EtienneESP32/fil-pilote-8-zones-eedomus/docs/11_Etat-KiCad.md

# État du projet KiCad natif

**Statut (2026-11-07, révisé) :** schéma électriquement complet et vérifié ERC ; implantation PCB placée et vérifiée DRC (hors routage). Ce projet KiCad devient la référence pour la topologie électrique — il intègre toutes les clôtures du 2026-11-06 (GPIO corrigés, étage tampon transistor, 4,7 kΩ + fusibles secteur, HLK-5M05, MOC3063M) que la copie EasyEDA R1 (`FilPilote_8Zones_DIN_R1_2026-11-06`, voir [08_Revue-schema-source](08_Revue-schema-source.md)) ne contient pas encore.

**Correction importante (2026-11-07) :** l'empreinte du connecteur de la carte Waveshare, livrée dans une première version de ce document, était un connecteur générique 1 rangée / 19 broches — sans rapport avec le vrai connecteur de la carte, repérée par l'utilisateur. Voir « Correction du connecteur Waveshare » ci-dessous pour le détail et les conséquences (deux affectations GPIO supplémentaires corrigées).

## Emplacement

- `hardware/kicad/FilPilote_8Zones.kicad_pro` — projet
- `hardware/kicad/FilPilote_8Zones.kicad_sch` — schéma (généré, voir `tools/generate_schematic.ps1`)
- `hardware/kicad/FilPilote_8Zones.kicad_pcb` — PCB (généré, voir `tools/generate_pcb.ps1`)
- `hardware/kicad/*.erc.json`, `*.drc.json` — rapports de vérification bruts
- `hardware/kicad/FilPilote_8Zones_render.png` — rendu visuel du placement

## Méthode

Le schéma et le PCB sont produits par deux scripts PowerShell (`tools/generate_schematic.ps1`, `tools/generate_pcb.ps1`) qui écrivent directement les fichiers texte `.kicad_sch`/`.kicad_pcb` au format KiCad 10, plutôt que d'utiliser l'éditeur graphique (non disponible dans cet environnement). Les symboles et empreintes sont des définitions minimales propres au projet (bibliothèque `FP`, non enregistrée dans une table de bibliothèque — d'où les avertissements bénins « bibliothèque FP introuvable » dans les rapports, sans impact électrique), à l'exception du connecteur Waveshare dont la géométrie a été vérifiée contre le vrai composant (voir ci-dessous). Chaque script a été validé empiriquement avec `kicad-cli` (erreurs de format corrigées par itération : inversion d'axe Y des broches de symbole, pas de grille, calcul d'offset, opérateur PowerShell qui répétait un tableau au lieu de multiplier une valeur).

**Piège `kicad-cli` trouvé (2026-11-07), à connaître avant toute régénération :** `kicad-cli pcb drc` et `kicad-cli pcb export svg` utilisent correctement les classes de net personnalisées (`Logique`/`Secteur`) pour le calcul demandé, **mais réécrivent ensuite `FilPilote_8Zones.kicad_pro` sur disque en supprimant ces classes** (seule la classe `Default` subsiste, `netclass_patterns` revient à `[]`) — un comportement de synchronisation de projet non documenté, pas une erreur de ce projet. Le résultat du DRC lancé À CE MOMENT-LÀ reste correct, mais le fichier projet est corrompu juste après et le resterait pour tout DRC ultérieur si on ne le restaure pas. **Toujours vérifier après toute commande `kicad-cli` touchant ce projet** (`git status` sur `FilPilote_8Zones.kicad_pro`, ou `grep -c Secteur` dessus) et restaurer (`git checkout -- hardware/kicad/FilPilote_8Zones.kicad_pro`) avant de committer. Pour un export SVG ou autre besoin ponctuel, préférer travailler sur une copie du projet dans un répertoire temporaire plutôt que sur les fichiers réels.

## Correction du connecteur Waveshare (2026-11-07)

**Ce qui était faux :** le connecteur `JWS` modélisait une rangée unique de 19 broches arbitraires, sans rapport avec la géométrie réelle de la carte Waveshare ESP32-S3-ETH.

**Vérification faite :** le pinout physique réel a été récupéré ([espboards.dev](https://www.espboards.dev/esp32/waveshare-esp32-s3-eth/), recoupé avec le wiki fabricant). La carte fait 72,8 × 21 mm et porte un **en-tête 40 broches compatible Raspberry Pi Pico** : 2 rangées de 20 broches, pas 2,54 mm, rangées espacées de 17,78 mm. Le connecteur `FP:CONN40_PICO` a été refait à l'identique de cette géométrie (vérifié par inspection directe des coordonnées de pastilles générées : deux colonnes à 10,00 mm et 27,78 mm d'écart exact).

**Deux erreurs d'affectation GPIO découvertes en croisant le pinout physique réel** (en plus de la correction GPIO33/34 déjà actée le 2026-11-06) :

| Zone/voie | GPIO précédent | Problème | GPIO corrigé |
|---|---:|---|---:|
| Zone 4, voie B | GPIO4 | Ne sort que sur le connecteur carte TF, absent de l'en-tête principal câblable | **GPIO45** |
| Zone 5, voie A | GPIO5 | Idem (carte TF uniquement) | **GPIO3** (broche de strapping JTAG ESP32-S3 ; risque limité à la sélection de source JTAG au démarrage, pas un risque de boot ; accepté faute d'alternative libre) |
| Zone 4, voie A | GPIO21 | Partagé avec la LED WS2812 embarquée de la carte | **Conservé** ; effet cosmétique accepté (la LED de statut suivra l'état de la zone 4 POS) |
| — | — | GPIO46 présent sur l'en-tête mais **entrée seule** sur ESP32-S3 | Exclu des candidats |

Table complète et à jour dans [02_Architecture-et-interfaces §2](02_Architecture-et-interfaces.md).

**Point fermé (2026-11-07), schéma fabricant réel consulté :** le schéma officiel ([ESP32-S3-ETH-Schematic.pdf](https://files.waveshare.com/wiki/ESP32-S3-ETH/ESP32-S3-ETH-Schematic.pdf)) montre que `POE_5V` est le même net que `VBUS` (USB-C) côté Waveshare — le module PoE s'enfiche sur un connecteur interne dédié, pas sur l'en-tête 40 broches. `VSYS` (broche 2) est la seule entrée externe accessible, déjà commutée en interne entre `VBUS`/PoE par un MOSFET (Q3, APM2307). Le sélecteur manuel `SW1` prévu initialement est donc **retiré** : il n'y a rien à sélectionner entre deux broches externes. Remplacé par une simple **diode série** (`DPWR`, 1N4007, anode HLK-5M05 / cathode `VSYS`) qui protège le HLK-5M05 d'un retour si le module PoE est malgré tout installé en parallèle. L'exclusion mutuelle PoE/local devient un choix d'assemblage à documenter dans la notice, pas un circuit électronique.

## Résultats de vérification (après correction)

- **ERC (schéma) :** 0 erreur, 0 avertissement résiduel hors bibliothèque. 248 avertissements bénins « bibliothèque FP introuvable », sans incidence électrique.
- **DRC (PCB) :** 0 erreur réelle. 138 avertissements bénins (même cause bibliothèque), **0 avertissement cosmétique résiduel** (les 6 chevauchements de repère silkscreen ont disparu après le recentrage des repères dans l'empreinte, voir plus bas — 2026-11-08). **144 des 188 connexions routées automatiquement par un autorouteur A* bicouche avec lissage de trajet** (F.Cu/B.Cu avec vias, 2 passes, conscient des classes de net Secteur/Logique, pistes lissées en ligne directe/diagonale quand c'est sûr plutôt qu'en escalier — script, voir [12_Guide-de-routage §0](12_Guide-de-routage.md)). Les 44 restantes ne sont pas simplement « non connectées » : elles sont matérialisées en **straps** directement dans le fichier `.kicad_pcb` (ligne de repère + étiquette sur la couche `Dwgs.User`, générées automatiquement, visibles à l'ouverture du PCB), avec une vérification réelle — pas une supposition — de la nécessité d'un fil isolé selon la proximité calculée avec l'autre classe de net (voir [12_Guide-de-routage §2](12_Guide-de-routage.md)).
- **Carte resserrée, 192 → 176 → 167 mm (2026-11-08) :** demande directe de l'utilisateur, en 2 temps. D'abord un pas variable (7 mm entre composants fins, 8 mm de part et d'autre de l'optotriac, remplaçant le pas uniforme de 9 mm — les composants 2 broches tournés à 90° n'ont quasiment aucun encombrement horizontal au-delà du rayon de leur pastille) + colonne connectique secteur/FP rapprochée (192→176 mm). Puis, l'utilisateur ayant repéré un **2e vide inutilisé au centre de la carte** (entre la colonne gauche de canaux et la colonne droite, ~21 mm de cuivre inutilisé) : colonnes rapprochées d'autant (176→167 mm), sans toucher au pas interne des canaux cette fois (donc sans nouveau risque sur le routage, confirmé : 144/188 inchangé). Un resserrement plus agressif du PAS interne (155 mm au lieu de 176 mm) a aussi été testé puis rejeté par l'utilisateur : 0 erreur DRC, mais 67 straps à souder au lieu de 34 (quasiment le double) — compromis jugé trop coûteux, non retenu. Conséquence attendue et acceptée du pas 7/8 mm retenu (176→167 mm) : 154 → 144 connexions auto-routées (34 → 44 straps), un vrai compromis taille/travail d'assemblage manuel, pas une régression.
- **Repères de valeur (ex. « 1N4007 », « 10k ») alignés sur le repère de référence (2026-11-08) :** signalé par l'utilisateur — seul le repère de référence (ex. « DZ1N ») avait été mis à la verticale/collé au composant ; la valeur restait horizontale et à son décalage par défaut. Corrigé en appliquant la même logique (même rotation, même côté, un peu plus loin pour ne pas chevaucher le repère de référence) à la propriété Value de tous les composants de canal, et à l'intérieur du boîtier de l'optotriac (empilée sous le repère de référence, toujours dans l'espace vide entre les 2 rangées de broches).
- **Pastilles d'ancrage de strap réactivées, numérotées par paire (2026-11-08) :** après un premier abandon le même jour (voir [12_Guide-de-routage §0](12_Guide-de-routage.md)), l'utilisateur a demandé de retenter l'idée avec un numérotage pairable — chaque strap a ses 2 extrémités numérotées pareil, suffixées A/B (ex. `S5A`/`S5B`), au lieu de 2 numéros globaux sans rapport visible entre eux. En la retentant (la dernière correction, jamais vérifiée avant l'abandon par manque de temps, s'est avérée fonctionner), résultat : **0 erreur DRC réelle**, 13 paires de pastilles d'ancrage posées avec succès sur 44 straps (les autres retombent proprement sur la connexion directe pastille-à-pastille, toujours sûre — pas une anomalie). 6 avertissements cosmétiques résiduels (chevauchement mineur de repère), laissés pour la finition silkscreen.
- **Repères silkscreen corrigés à la racine (2026-11-08) :** signalé par l'utilisateur en regardant le board. Vérifié par export SVG (pas supposé) que l'angle du texte n'hérite pas de la rotation du composant parent — le texte restait donc horizontal, mais décalé de 4 mm *vers un voisin*, ce qui causait 16 vrais chevauchements DRC (`silk_over_copper`), systématiquement le même (le repère `RS` pointant droit vers l'optotriac, large de 9,62 mm). Corrigé par deux changements demandés par l'utilisateur : le texte est maintenant tourné à 90° (se lit le long de l'axe du composant, comme ses broches empilées) et collé à seulement 1,8 mm au lieu de 4 mm ; et le repère de l'optotriac est placé **à l'intérieur même de son boîtier**, dans l'espace vide entre ses 2 rangées de broches (DIP-6 non tourné). Résultat : 0 avertissement silkscreen résiduel.
- **Correction d'implantation E/S RJ45 vs J1-J5, carte resserrée 167→154 mm (2026-11-08) :** l'utilisateur a demandé la vérification, sur le datasheet réel du coffret, que le RJ45 et les borniers J1-J5 sortent bien par des côtés compatibles avec les découpes du boîtier CNMB (deux extrémités opposées de l'axe qui scale avec le nombre de modules, jamais les deux grands côtés fixes à 86,5 mm). Vérification faite : J1-J5 sortent correctement vers le bord droit (une extrémité valide), mais le module Waveshare (`JWS`), monté à la verticale pour rester compact, a son RJ45 regroupé avec l'USB-C à une extrémité du module de 72,8 mm qui, dans cette orientation, sort vers le bord **haut** de la carte — un grand côté fixe, sans découpe standard (confirmé par le schéma de cotes officiel Waveshare, pas une supposition). Tourner le module de 90° pour aligner le RJ45 sur un bord valide coûterait directement 72,8 mm de largeur de carte, incompatible avec tout objectif de compaction. **Solution retenue avec l'utilisateur :** le module reste monté tel quel ; son RJ45 est relié par un court cordon interne à une prise RJ45 secondaire fixée au bord gauche (opposé à J1-J5) — liaison par câble, aucune piste PCB supplémentaire (détail mécanique dans [04_Implantation-PCB §1 et §6](04_Implantation-PCB.md)). À cette occasion, les 3 vides inter-colonnes (en-tête Waveshare↔zone gauche, zone gauche↔zone droite, zone droite↔connectique secteur) ont été resserrés sans toucher au pas interne des canaux (`$gapThin`/`$gapOC` inchangés, donc pas de risque supplémentaire sur le nombre de straps — confirmé : toujours 144/188 routées, 44 straps, inchangé) : carte 167→**154 mm**, sous la limite réelle CNMB/9 (156 mm utiles) avec 2 mm de marge. Les repères (`Reference`) et valeurs des composants axiaux 2 broches du canal (RB, RL, RS, F, D) ont en même temps été recentrés **dans** l'empreinte (même principe que l'optotriac, pas de pastille au centre local d'un axial 2 broches) au lieu de déborder de 1,8-2,8 mm vers un voisin — suggestion de l'utilisateur, qui a aussi fait disparaître les 6 avertissements cosmétiques de chevauchement silkscreen (voir ci-dessus). `Q` (TO92_3, 3 broches dont une au centre) garde son décalage latéral, le centre étant occupé par une pastille.
- **Correction de sécurité (2026-11-07) :** une vraie règle DRC d'isolement secteur/logique (6 mm, classes de net + fichier `.kicad_dru`) a été ajoutée — elle n'existait nulle part avant, voir [04_Implantation-PCB §3](04_Implantation-PCB.md). Son activation a révélé 234 violations réelles de placement (52 sous le minimum réglementaire IEC 60664-1), corrigées à la racine en changeant l'orientation d'un seul composant (l'optotriac, qui ne doit pas être tourné à 90° comme les autres). Le nombre de connexions auto-routées a baissé (172 → 153, puis remonté à 154 avec le lissage de trajet ajouté ensuite) non pas par régression, mais parce que le DRC vérifie désormais une contrainte réelle qu'il ignorait avant — la version précédente à 172 routées était **plus routée mais électriquement non sûre**.

## Ce que ça couvre

- Les 8 zones × 2 voies (POS/NEG), chacune : résistance de base → transistor tampon → résistance LED → MOC3063M → résistance secteur 4,7 kΩ → fusible/PTC → diode → sortie FPx, conforme aux décisions fermées du 2026-11-06.
- Section alimentation : diode anti-retour PoE/local (`DPWR`), HLK-5M05, AMS1117 dédié aux LED d'opto, découplage.
- Connectique : J1 (secteur), J2-J5 (FP1-FP8), en-tête Waveshare 40 broches réel (GND, VSYS, 16×GPIO câblés sur leurs broches physiques réelles ; les 21 autres broches — VBUS/3V3/3V3_EN/RUN/GPIO non retenus/réservés — sont non connectées).
- Implantation : colonne gauche (en-tête Waveshare + alimentation), 8 zones au centre en 4 bandes horizontales de 2 zones chacune, connectique secteur/FP en bord de carte droit.

## Révision du gabarit de carte et boîtier candidat

Le placement réel des 16 voies THT a montré que 105 × 85 mm (gabarit indicatif de la source) ne suffit pas. Une première extension à 105 × 180 mm a été reconsidérée : la hauteur d'un boîtier rail DIN modulaire est fixée par la gamme du fabricant, pas une dimension libre — seule la largeur varie avec le nombre de modules (1 module = 17,5 mm). La carte a d'abord été réorientée en 192 × 108 mm (~11 modules de large).

**Référence étudiée (2026-11-07) :** la gamme **CamdenBoss CNMB** (norme DIN 43880, quasi tous fabricants, disponible chez RS Components), datasheet officiel consulté. Section fixe **90 mm externe / 86,5 mm de PCB utilisable**, longueur qui scale avec le nombre de modules (`CNMB/12` = 212,1 mm, convient à notre longueur de 192 mm avec marge). Avantages concrets pour ce projet : **découpe RJ45 pré-percée disponible en pièce standard** (`CNMB/3/TGRJ45`, compatible tailles 3/6/9/12 — répond au point ouvert d'accès RJ45) et guide-fils/protège-bornes au pas **5,08 mm** (`CNMB/x/TG508`), qui correspond exactement au pas des borniers FP retenus dans la nomenclature.

**Carte recompactée en conséquence :** la carte 192×108 mm dépassait les 86,5 mm utilisables dans le sens de la section. Recompactée à **192 × 86 mm** (pas des bandes de zones resserré, dégagement de bord recalculé en tenant compte du rayon réel des pastilles) pour tenir en carte unique sous ce seuil, plutôt qu'un empilement de 2 PCB (également supporté par ce boîtier : « carries up to 3 PCBs horizontally »). DRC revalidé à 0 erreur réelle après compaction.

**Boîtier retenu, mis à jour (2026-11-08) :** base **CNMB/9/2** (156 mm de PCB utilisable, accès bornier aux deux extrémités opposées), couvercle **CNMB/9/PC** (transparent, choisi par l'utilisateur) — remplace le `CNMB/12` retenu le 2026-11-07, devenu surdimensionné une fois la carte resserrée à 154 mm. Accessoires : `CNMB/3/TGRJ45` × 3 au bord gauche (prise RJ45 secondaire + cordon interne depuis le module Waveshare, voir correction d'implantation E/S ci-dessus), `CNMB/3/TG508` × 3 côté J1-J5 (guide-fils 5,08 mm) — un CNMB/9 nécessite 3 segments modulaires de 52,8 mm par extrémité pour couvrir la largeur du boîtier. L'entrée secteur J1 est câblée en fixe par presse-étoupe plutôt qu'en bornier débrochable (évite un débranchement accidentel d'un conducteur 230 V) — voir [03_Nomenclature](03_Nomenclature.md).

**Confirmation CNMB/9 (2026-11-08) :** datasheet officiel CamdenBoss consulté directement (pas une extrapolation) — la gamme ne compte que les tailles /6, /9, /12 (pas de /8/10/11), avec une longueur de PCB utilisable réelle de 156 mm pour le /9. La carte à 154 mm y tient avec 2 mm de marge. Référence toujours à reconfirmer auprès du fabricant avant commande, même démarche que pour le `CNMB/12` initial.

**Profondeur interne vérifiée (2026-11-07) :** empilement réel depuis le PCB porteur jusqu'au point le plus haut = support femelle 2,54 mm (8,5 mm, hauteur standard du commerce) + épaisseur PCB Waveshare (1,6 mm) + composant le plus haut de la carte Waveshare, la prise RJ45 à magnétiques intégrées référencée `HC-RJ45` sur le schéma réel (≈13,4 mm, valeur typique pour ce type de connecteur) ≈ **23,5 mm au total**. Côté boîtier, 58 mm de profondeur externe moins parois et plots de fixation (≈5 mm) laisse ≈49 mm de dégagement utile. **Marge ≈2× le besoin** : la profondeur n'est pas un facteur limitant, même avec des hauteurs de composants estimées prudemment (pas mesurées sur pièce réelle).

## Orientation des borniers de câblage externe (2026-11-07)

**Ce qui était faux :** `J1` (secteur) et `J2`-`J5` (sorties FP) étaient posés à plat (rotation 0°), axe des 2 broches parallèle au bord de carte — sans rapport avec le sens de sortie réel d'un câble externe, signalé par l'utilisateur.

**Correction :** rotation à 90°, axe des 2 broches perpendiculaire au bord droit de la carte (sortie fil vers l'extérieur, X croissant). Vérifié par inspection directe des coordonnées de pastilles générées (ex. `J1` : les deux broches partagent `x=187.0`, espacées en `y` de ±2,54 mm autour du centre — confirmant l'axe perpendiculaire au bord). `F0` (fusible) et `PS1` (module HLK-5M05) n'ont pas de câblage externe direct (traces PCB uniquement) : orientation inchangée. DRC revalidé à 0 erreur réelle.

**Reste non traité :** le sens exact (quelle broche est « plus proche »/« plus loin » du bord) dépend de la référence réelle du bornier, pas encore choisie ; la position le long du bord (regroupement actuel près du coin) reste à confronter aux presse-étoupes/découpes réelles du boîtier une fois celui-ci commandé.

**Cohérence avec les 2 extrémités valides du boîtier, vérifiée (2026-11-08) :** J1-J5 sortent vers le bord droit, l'une des deux seules extrémités du CNMB où une découpe de câblage existe réellement (voir correction d'implantation E/S ci-dessus pour le cas du RJ45, qui lui ne sortait PAS d'un bord valide avant correction).

## Ce qui n'est pas fait

- **Routage des pistes** : un autorouteur A* bicouche (F.Cu/B.Cu, vias autorisés, 2 passes, conscient des classes Secteur/Logique, trajets lissés pour éviter les escaliers inutiles) par script a tracé 144 des 188 connexions (voir [12_Guide-de-routage §0](12_Guide-de-routage.md)). Les 44 restantes (surtout `MT1D_*` et `GPIO*` longue distance) sont bloquées localement par la saturation des 2 couches dans leur zone — plus nombreuses qu'avant le resserrement de la carte (192→167mm), compromis accepté — elles sont matérialisées en straps (guide + étiquette sur `Dwgs.User`, voir [12_Guide-de-routage §2](12_Guide-de-routage.md)) à souder à l'assemblage, pas à router en cuivre ; 13 d'entre elles ont en plus une paire de pastilles d'ancrage numérotées (`SxA`/`SxB`) pour faciliter le soudage.
- **Empreintes définitives des autres composants** : les empreintes hors connecteur Waveshare restent des gabarits génériques auto-cohérents (ex. `FP:DIP6`, `FP:TO92_3`), pas les empreintes réelles des références fabricant choisies. Elles sont correctes électriquement (mêmes numéros de broches que le schéma) mais leurs dimensions/pas exacts restent à confronter aux datasheets avant fabrication.
- **Plans de masse** : non définis (les classes de nets et largeurs de piste secteur/logique, elles, le sont désormais — voir [04_Implantation-PCB §3](04_Implantation-PCB.md)).
- **Table de bibliothèque locale** (`sym-lib-table`/`fp-lib-table`) : non créée ; à faire pour que KiCad propose nativement les symboles/empreintes en édition graphique (actuellement seulement en cache dans les fichiers, fonctionnel mais pas éditable comme bibliothèque séparée).
