EtienneESP32/fil-pilote-8-zones-eedomus/contour du projet.docx

Voici une synthèse technique complète, claire et sans ambiguïté à copier-coller directement pour soumettre votre projet à Claude :

# Synthèse Projet : Carte Contrôleur Fil Pilote 8 Zones (Rail DIN / ESP32 Ethernet)

## 1. Objectif du projet

Concevoir sous **EasyEDA Standard** le schéma et le circuit imprimé (PCB) d'une carte de pilotage pour **8 zones de chauffage par Fil Pilote**, intégrable dans un boîtier rail DIN (6 modules / 105 mm).

* **Contrainte d'assemblage :** Composants **100 % traversants (THT)** uniquement. Zéro CMS/SMD. Tout doit être soudable à la main sur pastilles perçées ou monté sur supports (DIP, barrettes femelles 2,54 mm).

* **Intégration domotique :** Firmware ESPHome / Home Assistant avec raccordement réseau filaire local (RJ45).

## 2. Architecture matérielle

### A. Contrôle & Connectivité

* **Microcontrôleur principal :** Platine **WT32-ETH01** (ESP32 avec port RJ45 femelle, PHY Ethernet LAN8720A, régulateur 3.3V intégré).

* Montée sur barrettes femelles THT au pas de 2,54 mm.

* Alimentation de la platine : sur sa broche `5V` (alimentée par le 5V du Hi-Link) et `GND`.

* Bus I2C pour communiquer avec l'expandeur : `IO33` (SDA) et `IO32` (SCL) (les broches standard 21/22 étant mobilisées en interne par l'Ethernet sur cette platine).

* **Expandeur d'E/S (I/O Expander) :** **MCP23017-E/SP** (boîtier DIP-28 THT).

* Alimentation : `VDD` sur `+3V3` (fourni par la broche 3V3 de la platine WT32-ETH01 ou rail 3.3V), `VSS` sur `GND`.

* Adresse I2C : broches 15, 16, 17 (`A0`, `A1`, `A2`) reliées à `GND` $\to$ adresse `0x20`.

* Broche 18 (`~RESET`) : portée au `+3V3`.

* Bus I2C : broche 12 (`SCL`) et broche 13 (`SDA`), avec résistances de tirage (*pull-up*) de 4,7 kΩ vers le `+3V3`.

* Sorties logiques : 16 E/S réparties pour piloter les 8 zones (2 sorties logiques par zone).

### B. Alimentation

* **Source primaire :** Module convertisseur AC/DC **HLK-PM01** (230V AC $\to$ 5V DC 600mA, boîtier fermé THT).

* Entrée 230V : reliée au bornier 2 pôles secteur `J1` (`N` et `L`).

* **Ligne Phase de commande (`PHASE_PROT`) :**

* La Phase 230V du bornier `J1` est distribuée vers l'étage de découpage des optotriacs sous le label `PHASE_PROT` (avec fusible 250V THT préconisé).

### C. Étage de puissance Fil Pilote (Répété à l'identique pour 8 zones)

Chaque zone est pilotée par 2 sorties logiques du MCP23017 :

1. **Alternance positive (Ordre Arrêt) :** active l'opto `POS`

2. **Alternance négative (Ordre Hors-Gel) :** active l'opto `NEG`

3. **Plein 230V sinusoïdal (Ordre Éco) :** active les deux optos simultanément

4. **Zéro signal (Ordre Confort) :** deux optos éteints

**Nomenclature par Zone :**

* 2 × Optotriacs : **MOC3041M** (DIP-6 THT) avec détection de passage par zéro (Zero-Crossing).

* 2 × Diodes : **1N4007** (boîtier DO-41 THT, 1000V 1A).

* 2 × Résistances côté commande basse tension : **330 Ω** 1/4W (axiale THT `AXIAL-0.3`).

* 2 × Résistances côté 230V secteur : **360 Ω** 1/2W ou 1/4W (axiale THT `AXIAL-0.3` ou `AXIAL-0.4`).

**Câblage type de la Zone X :**

* `Zx_POS` $\to$ Résistance 330 Ω $\to$ Broche 1 de l'opto 1 ; Broche 2 de l'opto 1 $\to$ `GND`.

* `Zx_NEG` $\to$ Résistance 330 Ω $\to$ Broche 1 de l'opto 2 ; Broche 2 de l'opto 2 $\to$ `GND`.

* `PHASE_PROT` $\to$ Résistance 360 Ω $\to$ Broche 6 de l'opto 1.

* `PHASE_PROT` $\to$ Résistance 360 Ω $\to$ Broche 6 de l'opto 2.

* Broche 4 de l'opto 1 $\to$ Anode de Diode 1 ; Cathode de Diode 1 $\to$ Nœud de sortie `FPx`.

* Broche 4 de l'opto 2 $\to$ Cathode de Diode 2 ; Anode de Diode 2 $\to$ Nœud de sortie `FPx`.

### D. Connectique externe (Borniers THT au pas de 5,0 mm / 5,08 mm)

* 1 × Bornier 2 pôles (**`J1`**) : Entrée 230V Secteur (Phase `L`, Neutre `N`).

* 4 × Borniers 2 pôles débrochables ou à vis (**`J2`, `J3`, `J4`, `J5**`) pour les 8 sorties Fil Pilote :

* Bornier 1 : `FP1`, `FP2`

* Bornier 2 : `FP3`, `FP4`

* Bornier 3 : `FP5`, `FP6`

* Bornier 4 : `FP7`, `FP8`

*(Note : les radiateurs ont leur neutre directement relié au tableau électrique).*

## 3. Cartographie d'adressage MCP23017 $\leftrightarrow$ Zones

| Sortie MCP23017 | Broche DIP-28 | Net Label | Zone associée |

| **GPA0** | Broche 21 | `Z1_POS` | Zone 1 (Arrêt) |

| **GPA1** | Broche 22 | `Z1_NEG` | Zone 1 (Hors-Gel) |

| **GPA2** | Broche 23 | `Z2_POS` | Zone 2 (Arrêt) |

| **GPA3** | Broche 24 | `Z2_NEG` | Zone 2 (Hors-Gel) |

| **GPA4** | Broche 25 | `Z3_POS` | Zone 3 (Arrêt) |

| **GPA5** | Broche 26 | `Z3_NEG` | Zone 3 (Hors-Gel) |

| **GPA6** | Broche 27 | `Z4_POS` | Zone 4 (Arrêt) |

| **GPA7** | Broche 28 | `Z4_NEG` | Zone 4 (Hors-Gel) |

| **GPB0** | Broche 1 | `Z5_POS` | Zone 5 (Arrêt) |

| **GPB1** | Broche 2 | `Z5_NEG` | Zone 5 (Hors-Gel) |

| **GPB2** | Broche 3 | `Z6_POS` | Zone 6 (Arrêt) |

| **GPB3** | Broche 4 | `Z6_NEG` | Zone 6 (Hors-Gel) |

| **GPB4** | Broche 5 | `Z7_POS` | Zone 7 (Arrêt) |

| **GPB5** | Broche 6 | `Z7_NEG` | Zone 6 (Hors-Gel) |

| **GPB6** | Broche 7 | `Z8_POS` | Zone 8 (Arrêt) |

| **GPB7** | Broche 8 | `Z8_NEG` | Zone 8 (Hors-Gel) |

## 4. État d'avancement actuel & Problématique restante

1. **Schéma :** Le bloc unitaire Zone 1 est validé électriquement. La duplication logique via Net Labels est arrêtée.

2. **Point à finaliser immédiatement :**

* Remplacement de l'ancien symbole CMS `WT32-S1` par la véritable empreinte THT de la platine **`WT32-ETH01`** dans EasyEDA.

* Vérification des broches I2C libres (`IO33` / `IO32` vs `IO4` / `IO14`) sur cette platine spécifique.

* Passage sous l'éditeur de PCB : dimensionnement du contour pour boîtier DIN (ex: 105 × 85 mm), placement physique garantissant la **barrière d'isolation galvanique de sécurité (crepage/clearance $\ge 6$ mm)** entre le plan secteur 230V et la logique basse tension, puis stratégie de routage des pistes 230V et du bus logique.
