EtienneESP32/fil-pilote-8-zones-eedomus/docs/05_Firmware-et-exploitation.md

# Firmware et exploitation

**Statut :** exigences fonctionnelles proposées; aucun firmware n'est présent dans le dossier. L'intégration visée est eedomus, sans Home Assistant.

## 1. Plateforme et intégration

- Contrôleur candidat : Waveshare ESP32-S3 ETH avec Ethernet/RJ45 et PoE proposé, Wi-Fi et Bluetooth.
- Protocole d'intégration eedomus à définir; proposition initiale : API HTTP locale appelée par eedomus, avec commandes de mode et lecture de statut.
- Home Assistant n'est pas requis.
- MCP23017/I2C retiré de l'architecture (2026-11-06) : 16 GPIO directs confirmés, chacun pilotant un transistor tampon (voir [02_Architecture](02_Architecture-et-interfaces.md)).

Le pinout et le mécanisme réseau de la carte Waveshare devront être vérifiés avant le firmware. L'API eedomus devra préciser l'authentification locale, le format des commandes, l'accusé de réception et la lecture d'état.

## 2. Convention de commande par zone

| Ordre | Codage matériel/temps | Statut |
|---|---|---|
| Confort | À spécifier selon GIFAM | Ouvert |
| Éco | À spécifier selon GIFAM | Ouvert |
| Hors-gel | À spécifier selon GIFAM | Ouvert |
| Arrêt | À spécifier selon GIFAM | Ouvert |
| Confort -1 °C | À spécifier selon GIFAM | Ouvert |
| Confort -2 °C | À spécifier selon GIFAM | Ouvert |

La paire de sorties de la conception initiale fournit quatre combinaisons statiques seulement. Les six ordres exigent une table de génération comprenant les éventuelles séquences temporelles; ne pas coder les modes avant validation de cette table et du circuit de puissance.

Référence de travail à examiner : [`epsilonrt/gifam-chip`](https://github.com/epsilonrt/gifam-chip) décrit Confort -1 °C comme signal complet 3 s / silence 4 min 57 s, et Confort -2 °C comme signal complet 7 s / silence 4 min 53 s. Ces temporisations sont une implémentation communautaire à confirmer avant intégration finale.

## 3. Séquence de démarrage attendue

À spécifier et tester :

1. Maintenir les sorties dans l'état matériel sûr pendant l'alimentation et le reset.
2. Initialiser les GPIO et les drivers à un état connu avant d'accepter des commandes réseau.
3. Charger la dernière consigne persistée, appliquer le mode seulement après initialisation complète et signaler tout échec.
4. Signaler l'état réseau séparément de l'état réel ou présumé des sorties.

L'état sûr exact et la politique de reprise restent à décider avec le comportement des appareils de chauffage. Ne pas supposer que « toutes les sorties à zéro » est le choix sûr sans valider le système complet.

## 4. Défauts et perte de communication

Décisions à documenter avant mise en service :

- Perte Ethernet/eedomus : conserver la dernière consigne reçue.
- Redémarrage de l'ESP32 : restaurer la dernière consigne persistée et prévenir les impulsions transitoires.
- Commande invalide ou contradictoire : rejet atomique, journalisation et maintien de l'état convenu.
- Watchdog et redémarrages répétés : comportement déterministe des sorties.

## 5. Convention de nommage proposée

- Commandes : `zone1_mode` à `zone8_mode`, chacune acceptant `confort`, `eco`, `hors_gel`, `arret`, `confort_moins_1`, `confort_moins_2`.
- Diagnostic : état Ethernet, dernière commande reçue, consigne appliquée, version firmware et dernière erreur.
- Valider avec eedomus les noms de périphériques, la méthode d'appel et le format des retours avant réalisation.
