EtienneESP32/fil-pilote-8-zones-eedomus/hardware/kicad/FilPilote_8Zones_render.png

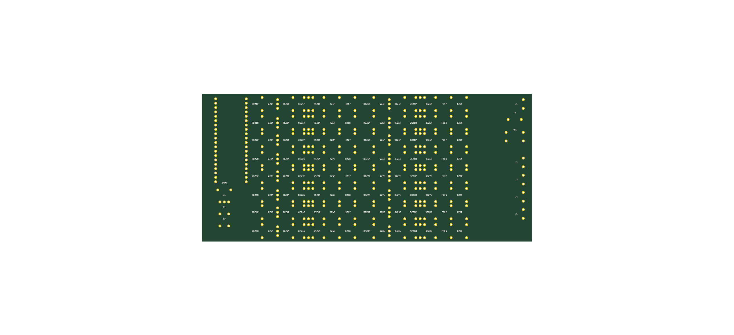
hardware/kicad/FilPilote_8Zones_render.png
