EtienneESP32/fil-pilote-8-zones-eedomus/docs/12_Guide-de-routage.md

# Guide de routage PCB

**Statut (révisé 2026-11-08) :** un autorouteur A* **bicouche, en 2 passes, conscient des classes de net Secteur/Logique, avec lissage de trajet** (`tools/generate_pcb.ps1`, fonctions `Find-Path`/`Emit-Path`, F.Cu + B.Cu avec vias) route automatiquement **144 des 188 connexions**, 0 erreur DRC réelle — y compris la règle d'isolement 6 mm secteur/logique, désormais une vraie règle DRC vérifiée (voir § 1, et l'historique ci-dessous : elle n'existait nulle part avant ce jour). Les **44 connexions restantes sont déjà matérialisées dans le fichier `.kicad_pcb` lui-même** : une ligne pointillée exacte (pastille à pastille) et une étiquette texte sur la couche `Dwgs.User`, visibles directement à l'ouverture du PCB dans KiCad, pas seulement décrites ici. Voir § 2.

**Important pour la suite :** le nombre de connexions auto-routées a baissé par rapport à une version intermédiaire de ce jour (172 → 153). Ce n'est pas une régression : cette version à 172 routait plus, mais sans jamais vérifier la séparation 6 mm secteur/logique (la règle n'était pas encore implémentée) — elle était électriquement non sûre, pas seulement incomplète. Voir [04_Implantation-PCB §3](04_Implantation-PCB.md) pour le détail de cette découverte et de sa correction (réorientation de l'optotriac).

## 0. Comment fonctionne l'autoroutage par script, et ses limites

Première tentative (ligne droite pure) : seules les connexions entre composants **directement voisins** (1 pas d'écart, ex. `QB_*`/`LEDA_*`) passaient sans toucher un composant intermédiaire ; tout le reste créait des courts-circuits DRC réels en ligne droite. Remplacé par un vrai **pathfinding A*** :

- **Modèle d'obstacles :** chaque broche de chaque composant (connectée ou non) est un obstacle individuel (boîte ~2,2×2,2 mm, rayon de pastille + marge de dégagement) — pas le composant entier. Un composant entier comme obstacle unique laissait une piste traverser librement les **autres** broches du même composant dès que ce composant était à une extrémité du chemin (confirmé par de vrais courts-circuits DRC sur des boîtiers à broches rapprochées comme le DIP-6 ou le TO-92, pas 1,27-2,54 mm) ; au niveau de la broche, seules les deux broches exactes visées par la piste en cours sont exclues du blocage (par coordonnée, pas par référence de composant), toutes les autres broches du même composant restent bloquantes.
- **Déplacement 4 directions uniquement** (horizontal/vertical, jamais diagonal) : un déplacement diagonal produit, une fois simplifié, un segment dont le rectangle englobant (utilisé comme obstacle pour les pistes suivantes) est disproportionné par rapport à l'encombrement réel de la piste — constaté en pratique (une fenêtre de recherche se retrouvait bloquée à 74 % dès la 2e/3e piste routée avec déplacement 8 directions).
- **Ordre de routage** : les nets les plus contraints (connexions locales à 1-2 pas, `QB_*`/`LEDA_*`/`RSF_*`, puis `LEDK_*`/`FMT2_*`/`MT1D_*`, puis `GPIO*`, puis `FP*`) sont routés **avant** les nets bus à forte connectivité (`GND`, `VSYS`, etc.). Router un bus en premier pouvait tracer une piste traversant la position exacte d'une broche qu'un net local tentait d'atteindre juste après — bug réel diagnostiqué et corrigé.
- **Recherche bicouche avec vias (ajouté 2026-11-07) :** avec une seule couche de cuivre (B.Cu), les familles `LEDK_*`/`FMT2_*`/`MT1D_*` échouaient **en bloc** (16/16 canaux), alors que `LEDA_*`/`QB_*`/`RSF_*` (routées juste avant, même longueur de trajet) réussissaient — preuve que la cause n'était pas géométrique mais une saturation de la seule couche disponible par les ~48 premières pistes. L'A* recherche maintenant sur F.Cu **et** B.Cu simultanément, avec un changement de couche (via, coût de détour équivalent à 5 mm) autorisé à toute case de la grille où l'autre couche est libre. Résultat : 90 → 157 connexions routées (31 vias posés).
- **Fenêtre de recherche locale bornée** (marge 20 mm autour du segment direct start→end, résolution de grille 1 mm) plutôt qu'une recherche sur la carte entière, pour rester rapide.
- **2e passe ciblée sur les seuls échecs (ajouté 2026-11-07) :** après la passe normale, chaque échec est retenté avec une fenêtre plus large (60 mm) et une grille plus fine (0,5 mm, pour trouver les interstices sub-millimétriques qu'une grille à 1 mm arrondissait à « bloqué »). Comme ces échecs ne sont plus en concurrence avec des nets encore à router (tout le reste est déjà fixé), élargir leur fenêtre ne dégrade rien d'autre — contrairement à un élargissement en 1ère passe (35 mm testé, résultat dégradé à 150 routées : le routeur étant glouton/séquentiel, un chemin plus généreux pour un net consomme de la place qu'un net suivant pourrait réclamer). Résultat de cette 2e passe : 157 → **172** connexions routées. Un 3e palier à 110 mm a aussi été testé sur les échecs résiduels : **0 connexion récupérée en plus**, confirmant que les 16 échecs finaux sont bloqués par la topologie/saturation locale, pas par une fenêtre trop étroite — une fenêtre plus large ne réussit jamais à débloquer une case qui est réellement occupée par un autre composant/piste/via.
- **Essais rejetés** (gardés ici pour ne pas les retenter) : trier les nets `LEDK_*`/`FMT2_*`/`MT1D_*` par canal plutôt que par famille (pour éviter que `MT1D_*`, traité en dernier alphabétiquement, ne parte toujours sur un couloir déjà saturé par les 32 autres) — `MT1D_*` s'améliorait bien, mais `PHASE_PROT`/`3V3_OPTO` se dégradaient davantage, résultat net 154 vs 157 ; coût de via réduit à 2 mm (au lieu de 5) pour favoriser le changement de couche — résultat dégradé à 148.
- **Isolement secteur/logique réellement vérifié (ajouté 2026-11-07) :** la séparation documentée de 6 mm n'était vérifiée par aucune règle DRC — seule la documentation et le placement « par construction » l'assuraient. Deux vraies classes de net (`Logique`, `Secteur`) et une règle DRC personnalisée (`hardware/kicad/FilPilote_8Zones.kicad_dru`) ont été ajoutées au projet KiCad ; chaque obstacle du pathfinder (broche, piste, via) porte maintenant la classe de son net, et `Find-Path` impose 6 mm entre classes différentes (0,3-0,55 mm sinon, selon la classe). Activer cette règle a immédiatement révélé **234 violations réelles** sur le board précédent (172 routées), dont **52 sous le minimum réglementaire IEC 60664-1 de 2 mm** (pire cas 0,78 mm) — un vrai défaut de **placement**, pas de routage : deux optotriacs (MOC3063M) de canaux/bandes voisins avaient leurs broches logique et secteur à quelques mm l'une de l'autre, parce que chaque composant de la pile est tourné à 90° pour l'empilement (voir § 1), ce qui faisait basculer la séparation logique/secteur interne de l'optotriac (normalement sur l'axe X du boîtier DIP-6) sur l'axe Y des canaux/bandes. **Corrigé en ne tournant plus l'optotriac** (seul composant concerné) — son orientation naturelle garde cette séparation sur X, indépendante de toute position Y, donc du canal/bande voisin. 0 violation de clearance réelle après correction ; le nombre auto-routé a baissé à 153 car la contrainte est maintenant réelle, pas parce que le routeur a régressé.
- **Chanfreinage des coins à 45° (ajouté 2026-11-07, révisé 2026-11-08) :** le pathfinder en grille ne se déplace qu'horizontalement/verticalement (voir plus haut), ce qui produit de vrais escaliers même quand un coin net serait tout aussi sûr électriquement — repéré visuellement par l'utilisateur. Une première version lissait par « string pulling » (sauter directement au point le plus loin possible, diagonale comprise) : jugée **trop sale visuellement** par l'utilisateur une fois vue sur le board — trop de pistes en biais à angle arbitraire, pas la convention PCB habituelle (majoritairement horizontal/vertical, chanfreins courts aux coins). Remplacée par un **chanfreinage de coin** classique : chaque coin à 90° du chemin simplifié est coupé sur une petite longueur égale (≤2 mm) de ses 2 segments, reliée par un segment direct — toujours exactement à 45° puisque les 2 segments d'origine sont horizontaux/verticaux. Chaque chanfrein reste vérifié (`Test-LineSafe`) avant d'être retenu, jamais supposé sûr. Un bug de calcul (référence au point d'origine au lieu du dernier point réellement émis) faisait parfois coïncider 2 chanfreins voisins, créant un segment de piste de longueur 0 (`track_dangling` réel au DRC) — corrigé en chaînant chaque chanfrein au précédent, comme `Simplify-Run` le fait déjà. Résultat : coins nets plutôt qu'escaliers ou diagonales longues, 153 → 154 connexions routées (effet de bord), 0 erreur DRC réelle après vérification complète.
- **Pastilles d'ancrage pour les straps : abandonnées puis réactivées avec succès (2026-11-08) :** idée proposée par l'utilisateur — souder un strap directement sur la patte d'un connecteur/composant est peu pratique ; mieux vaut une courte piste (~5 mm) vers une pastille dédiée. Implémentée, puis 4 vrais bugs trouvés et corrigés un par un au fil de la vérification DRC systématique (chevauchement du propre composant d'origine faute d'une longueur de fuite suffisante, rayon de la pastille traversante jamais vérifié sur l'autre face, marge de bord de carte absente, chevauchement de contour visuel résiduel). La dernière correction (distance de fuite minimale calculée depuis le contour réel du composant d'origine, garantissant d'en sortir quelle que soit la direction choisie) n'a jamais pu être vérifiée par un DRC complet avant un premier abandon par manque de temps. **Retentée à la demande de l'utilisateur**, avec en plus un numérotage pairable (les 2 extrémités d'un même strap partagent le même numéro, suffixé `A`/`B` — ex. `S5A`/`S5B` — au lieu de 2 numéros globaux sans rapport visible entre eux) : résultat **0 erreur DRC réelle**, 13 paires posées avec succès sur 44 straps (les autres retombent proprement sur la connexion directe, toujours sûre, plutôt que de forcer une position risquée). 6 avertissements cosmétiques résiduels (chevauchement mineur de repère), laissés pour la finition silkscreen.
- **Carte resserrée et repères silkscreen corrigés à la racine (2026-11-08) :** demande directe de l'utilisateur, voir [11_État du projet KiCad](11_Etat-KiCad.md) pour le détail complet (pas variable `$gapThin`/`$gapOC` remplaçant le pas uniforme de 9 mm, colonne secteur/FP rapprochée, repères tournés à 90° et collés au composant au lieu d'un décalage de 4 mm vers un voisin, repère de l'optotriac déplacé à l'intérieur même de son boîtier). Board 192 → 176 mm, 0 erreur DRC réelle, 0 avertissement silkscreen résiduel. Conséquence directe et acceptée : 154 → 144 connexions auto-routées (34 → 44 straps) — les couloirs de routage se réduisent avec la carte, compromis choisi explicitement par l'utilisateur après comparaison avec un resserrement plus agressif (155 mm, 121 routées, 67 straps) jugé trop coûteux.
- **Vides inter-colonnes resserrés une 3e fois, 167 → 154 mm (2026-11-08) :** à l'occasion de la correction d'implantation E/S (RJ45 vs bord valide du boîtier CNMB, voir [11_État du projet KiCad](11_Etat-KiCad.md)), les 3 vides restants entre colonnes (en-tête Waveshare↔zone gauche, zone gauche↔zone droite, zone droite↔connectique secteur) ont été réduits SANS toucher `$gapThin`/`$gapOC` (le pas interne des canaux, seul paramètre dont le resserrement avait coûté des straps lors de l'essai à 155 mm ci-dessus) — chaque nouveau vide a été vérifié à la main (distance pastille-à-pastille réelle, pas juste la distance centre-à-centre) pour rester au-dessus du minimum 6 mm secteur/logique à chaque frontière concernée, avec une marge d'au moins 0,4 mm. Résultat confirmé par génération complète : **144/188 routées, 44 straps, strictement identique à avant** — ce resserrement-ci n'a coûté aucun strap supplémentaire, contrairement à celui du pas interne. En prime, le recentrage des repères `RB`/`RL`/`RS`/`F`/`D` à l'intérieur de leur empreinte (même principe que l'optotriac, demande utilisateur) a fait tomber les 6 derniers avertissements cosmétiques de chevauchement silkscreen à 0.

Chaque régénération est vérifiée par DRC systématique (`kicad-cli pcb drc`) ; les connexions qui échouent sont listées en sortie du script sous « echecs (a router a la main) » et ne sont jamais forcées.

## 1. Avant de router

1. Ouvrir `hardware/kicad/FilPilote_8Zones.kicad_pro`, éditeur PCB.
2. Vérifier que le ratsnest (fils logiques fins) relie bien toutes les pastilles.
3. Les classes de net sont **déjà définies dans le projet** (plus une étape manuelle à faire, voir § 0 et [04_Implantation-PCB](04_Implantation-PCB.md)) :

| Classe | Nets | Largeur piste | Clearance |
|---|---|---|---|
| Logique | `GPIO*`, `QB_*`, `LEDA_*`, `LEDK_*`, `GND`, `VSYS`, `3V3_OPTO`, `LOCAL_5V` | 0,3 mm | 0,2 mm (standard) |
| Secteur | `PHASE_PROT`, `MAINS_L`, `MAINS_N`, `RSF_*`, `FMT2_*`, `MT1D_*`, `FP1`…`FP8` | 0,4 mm | 0,5 mm (entre nets Secteur) |

La règle **Secteur ↔ Logique = 6 mm** n'est pas une clearance de classe (qui s'appliquerait uniformément y compris entre deux nets Secteur, rendant leur routage mutuel impossible à ce pas de carte) mais une règle DRC personnalisée conditionnelle, dans `hardware/kicad/FilPilote_8Zones.kicad_dru`, qui ne s'applique qu'à la frontière entre les deux classes. Elle reprend la valeur déjà validée dans [04_Implantation-PCB](04_Implantation-PCB.md) (dépasse le minimum IEC 60664-1 pour cette plage de tension). Le courant de défaut côté secteur est limité à ~49 mA par les résistances 4,7 kΩ (voir [03_Nomenclature](03_Nomenclature.md)) : pas besoin de cuivre épais façon piste de puissance, la largeur proposée est un confort mécanique/thermique, pas un calcul de courant fort.

4. Les optotriacs (MOC3063M, DIP-6) sont le seul pont autorisé entre logique et secteur, par construction du composant (et par l'orientation non tournée de ce composant précisément, voir § 0) — aucune piste ne doit créer un 2e pont ailleurs. Lancer le DRC (F8) confirmera toute violation de la règle des 6 mm si c'est le cas.

## 2. Ordre de routage recommandé (ce qu'il reste à faire)

**Entièrement auto-routés par le script (rien à faire, sauf vérification visuelle) :** `QB_*`, `LEDA_*`, `RSF_*`, `LEDK_*` et la majorité de `FMT2_*`/`GPIO*`/`FP*` — 144 connexions au total, vias posés pour passer sur l'autre couche dans les zones denses, tout en respectant la règle des 6 mm.

**Reste à router — 44 straps, générés automatiquement sur la couche `Dwgs.User` (`Add-Strap` dans `generate_pcb.ps1`) :**

Chaque échec, après les 2 passes de pathfinding, obtient automatiquement : une ligne pointillée exacte entre les 2 pastilles réelles à relier, et une étiquette texte `STRAP <net> (<classe>, <nu ou isolé/FIL ISOLE OBLIGATOIRE>) : <ref A> <-> <ref B>`. La mention d'isolation n'est pas une précaution générique : le script calcule la distance réelle entre le trajet direct du strap et la broche la plus proche de l'autre classe (Secteur/Logique) et ne marque « FIL ISOLE OBLIGATOIRE » que si cette distance est réellement sous 6 mm.

1. **`MT1D_*`** (14 des 16 canaux) et **`FMT2_*`** (11 des 16 canaux) : restent côté secteur sur toute leur longueur (`OC → D`/`F`, pas de voisinage logique sur le trajet) — **fil nu ou isolé, peu importe**, confirmé par le calcul ci-dessus. Plus nombreux qu'avant le resserrement de la carte (couloirs de routage réduits avec le pas de canal, voir § 0).
2. **`GPIO3`, `38`-`42`, `47`, `48`** (`JWS → RB` zones 5-8), **`FP1`-`FP4`**, **`3V3_OPTO`** (2 segments), **`GND`** (2 segments), **`LOCAL_5V`**, **`PHASE_PROT`** (2 segments) : leur trajet direct passe à moins de 6 mm d'une broche de l'autre classe à un moment donné (traversées longue distance qui longent la frange secteur/logique) — **fil isolé obligatoire** (gaine PVC standard, tension assignée ≥ 300 V, suffit largement pour ce cas et fournit sa propre barrière d'isolement indépendamment de la position).

Le ratsnest indique déjà la paire de pastilles à relier, mais le guide visuel sur `Dwgs.User` donne le tracé exact à suivre (pas seulement les 2 points, la ligne elle-même) — ouvrir le PCB dans KiCad suffit pour voir les 44 repères.

## 3. Pendant le routage

- Ne jamais router une piste à moins de 6 mm d'une piste/pastille de l'autre classe (Secteur vs Logique) — ce n'est plus seulement une convention, le DRC (F8) le signale désormais explicitement par la règle `isolement_secteur_logique_6mm`.
- Les 44 connexions restantes sont déjà matérialisées en **straps** (cavalier filaire, parfois appelé pont ou cavalier 0 Ω) sur la couche `Dwgs.User` du PCB généré — voir § 2 pour le détail et la mention nu/isolé par connexion. 13 d'entre elles se terminent sur une **pastille d'ancrage dédiée** (`SxA`/`SxB`, reliée au composant réel par une courte piste) plutôt que directement sur la patte du composant/connecteur — plus pratique à souder ; les 31 autres relient directement les 2 pattes d'origine, faute d'avoir trouvé une position d'ancrage sûre à proximité. Contrairement à une piste ou un via, un strap n'est pas contraint par la géométrie 2D du cuivre déjà posé : il relie directement 2 points par le dessus, ce qui correspond exactement à la situation ici (zones saturées sur les 2 couches, pas un trajet impossible dans l'espace).
- Ces repères `Dwgs.User` sont volontairement **non fabriqués** (pas un calque Gerber envoyé au fabricant) : le ratsnest de ces 44 nets restera affiché « non connecté » dans KiCad jusqu'à ce que le fil soit réellement soudé à l'assemblage — c'est le comportement correct, pas une anomalie à corriger.
- Lancer le DRC (F8) après chaque zone routée, pas seulement à la fin.

## 4. Finition

1. DRC complet, toutes règles actives, 0 erreur.
2. Si plan de masse utilisé : remplir les zones de cuivre, puis relancer le DRC (le remplissage peut révéler de nouvelles violations de clearance).
3. Vue 3D : vérifier visuellement l'absence de chevauchement composant/boîtier/voisin.
4. Sérigraphie : repères `FP1`-`FP8` et polarités (diodes, condensateur électrolytique, transistor) lisibles et correctement orientés.
5. Export Gerbers/perçage seulement après tout ce qui précède, et après revue par une personne compétente (secteur 230 V impliqué) — voir [06_Plan-de-validation](06_Plan-de-validation.md).
