EtienneESP32/fil-pilote-8-zones-eedomus/Schematic_FilPilote_8Zones_DIN_2_2026-11-06.pdf

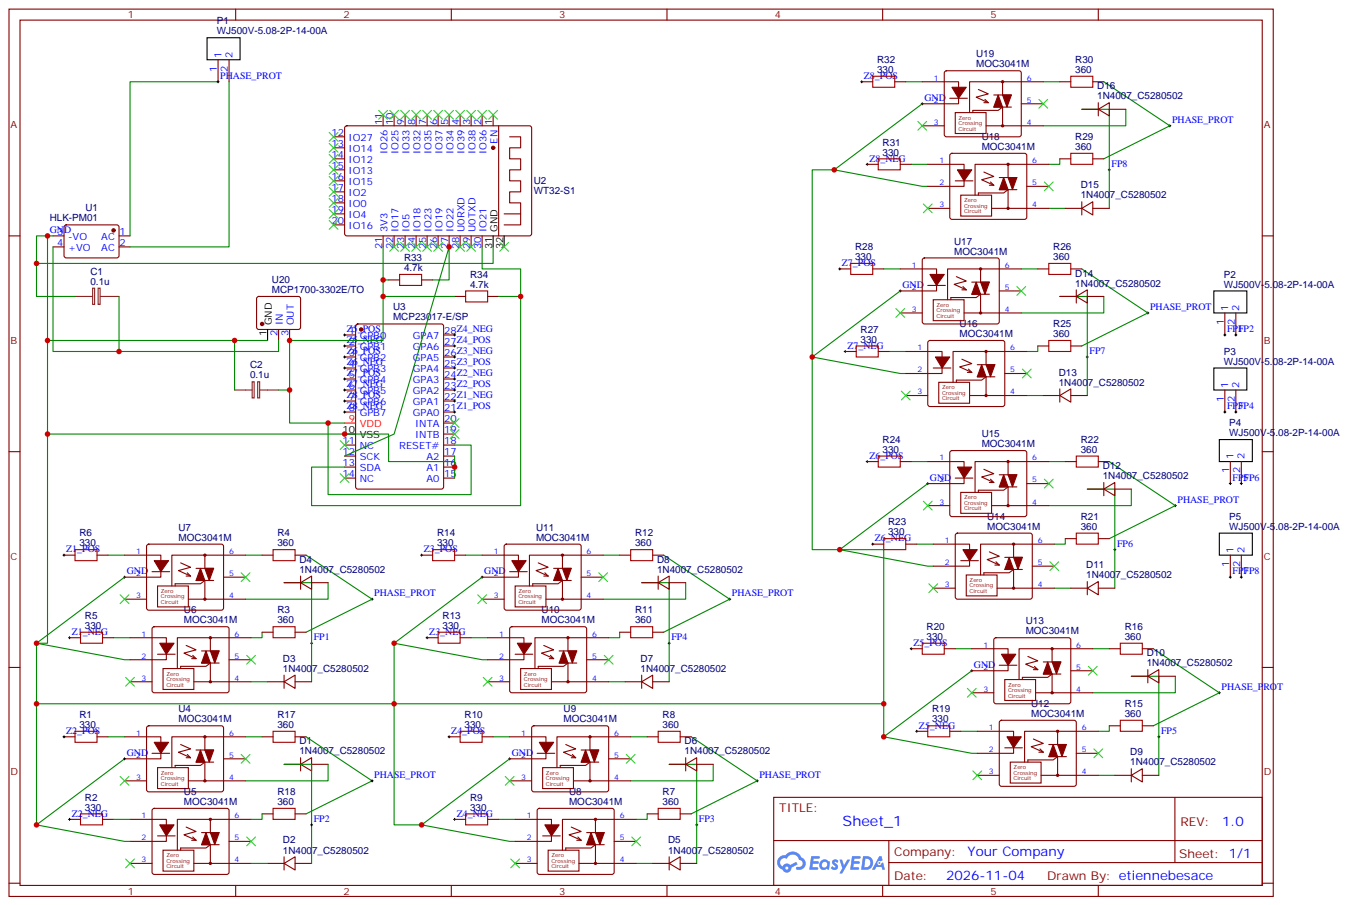
[picture p2: page 1]
