EtienneESP32/fil-pilote-8-zones-eedomus/(list of files, drawings)

Other design files:
SCH_FilPilote_8Zones_DIN_2_2026-11-06.json
