EtienneESP32/fil-pilote-8-zones-eedomus/hardware/kicad/FilPilote_8Zones.kicad_pcb

## KiCad design hardware/kicad/FilPilote_8Zones.kicad_pcb (2026-11-08)

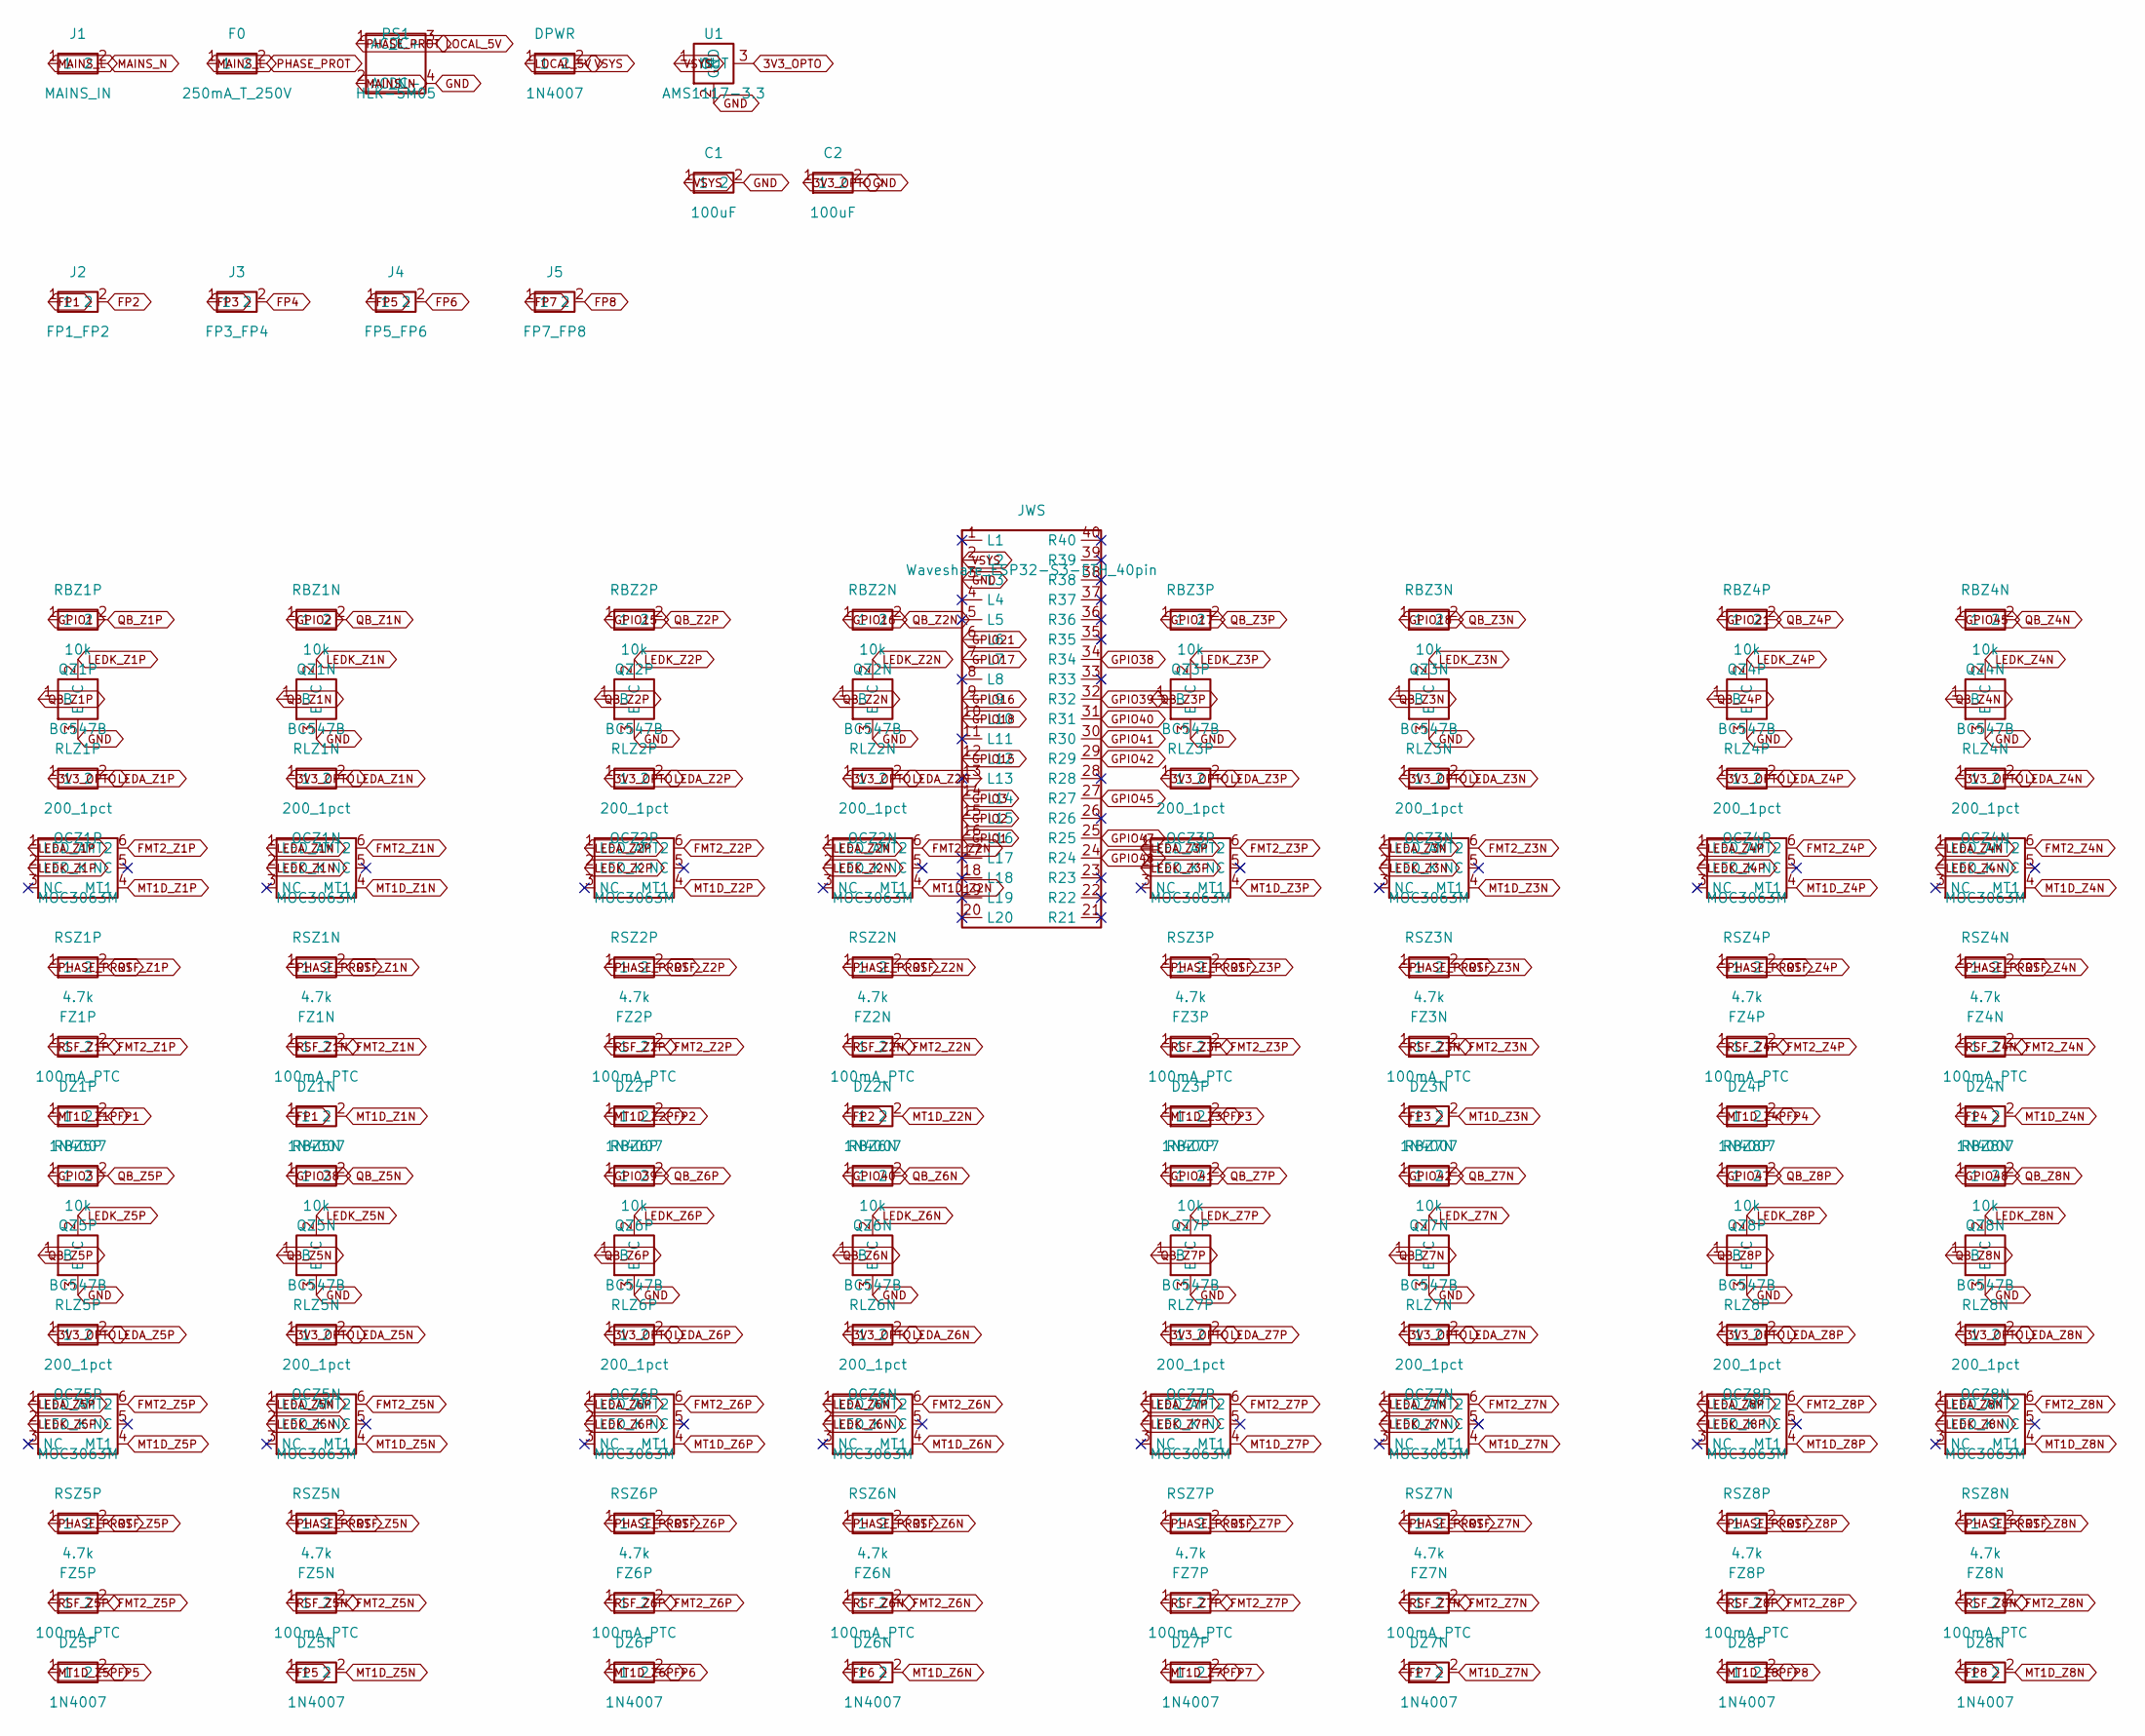
[picture p3: schematic FilPilote_8Zones.kicad_sch]

Parts:
C1, C2: 100uF; CAP_THT_Radial
DPWR: 1N4007; DO41_THT
DZ1N, DZ1P, DZ2N, DZ2P, DZ3N, DZ3P, DZ4N, DZ4P, DZ5N, DZ5P, DZ6N, DZ6P, DZ7N, DZ7P, DZ8N, DZ8P: 1N4007; DO41_THT
F0: 250mA_T_250V; Axial_THT
FZ1N, FZ1P, FZ2N, FZ2P, FZ3N, FZ3P, FZ4N, FZ4P, FZ5N, FZ5P, FZ6N, FZ6P, FZ7N, FZ7P, FZ8N, FZ8P: 100mA_PTC; Axial_THT
J1: MAINS_IN; TerminalBlock_2.54_2pin
J2: FP1_FP2; TerminalBlock_5.08_2pin
J3: FP3_FP4; TerminalBlock_5.08_2pin
J4: FP5_FP6; TerminalBlock_5.08_2pin
J5: FP7_FP8; TerminalBlock_5.08_2pin
JWS: Waveshare_ESP32-S3-ETH_40pin; PinHeader_2x20_2.54_Pico
OCZ1N, OCZ1P, OCZ2N, OCZ2P, OCZ3N, OCZ3P, OCZ4N, OCZ4P, OCZ5N, OCZ5P, OCZ6N, OCZ6P, OCZ7N, OCZ7P, OCZ8N, OCZ8P: MOC3063M; DIP6_THT
PS1: HLK-5M05; Module_PSU4
QZ1N, QZ1P, QZ2N, QZ2P, QZ3N, QZ3P, QZ4N, QZ4P, QZ5N, QZ5P, QZ6N, QZ6P, QZ7N, QZ7P, QZ8N, QZ8P: BC547B; TO92_BEC
RBZ1N, RBZ1P, RBZ2N, RBZ2P, RBZ3N, RBZ3P, RBZ4N, RBZ4P, RBZ5N, RBZ5P, RBZ6N, RBZ6P, RBZ7N, RBZ7P, RBZ8N, RBZ8P: 10k; Axial_THT
RLZ1N, RLZ1P, RLZ2N, RLZ2P, RLZ3N, RLZ3P, RLZ4N, RLZ4P, RLZ5N, RLZ5P, RLZ6N, RLZ6P, RLZ7N, RLZ7P, RLZ8N, RLZ8P: 200_1pct; Axial_THT
RSZ1N, RSZ1P, RSZ2N, RSZ2P, RSZ3N, RSZ3P, RSZ4N, RSZ4P, RSZ5N, RSZ5P, RSZ6N, RSZ6P, RSZ7N, RSZ7P, RSZ8N, RSZ8P: 4.7k; Axial_THT
U1: AMS1117-3.3; TO220_3pin

Connections:
3V3_OPTO: C2.1, RLZ1N.1, RLZ1P.1, RLZ2N.1, RLZ2P.1, RLZ3N.1, RLZ3P.1, RLZ4N.1, RLZ4P.1, RLZ5N.1, RLZ5P.1, RLZ6N.1, RLZ6P.1, RLZ7N.1, RLZ7P.1, RLZ8N.1, RLZ8P.1, U1.3 (OUT); also elsewhere on the board
FMT2_Z1N: FZ1N.2, OCZ1N.6 (MT2)
FMT2_Z1P: FZ1P.2, OCZ1P.6 (MT2)
FMT2_Z2N: FZ2N.2, OCZ2N.6 (MT2)
FMT2_Z2P: FZ2P.2, OCZ2P.6 (MT2)
FMT2_Z3N: FZ3N.2, OCZ3N.6 (MT2)
FMT2_Z3P: FZ3P.2, OCZ3P.6 (MT2)
FMT2_Z4N: FZ4N.2, OCZ4N.6 (MT2)
FMT2_Z4P: FZ4P.2, OCZ4P.6 (MT2)
FMT2_Z5N: FZ5N.2, OCZ5N.6 (MT2)
FMT2_Z5P: FZ5P.2, OCZ5P.6 (MT2)
FMT2_Z6N: FZ6N.2, OCZ6N.6 (MT2)
FMT2_Z6P: FZ6P.2, OCZ6P.6 (MT2)
FMT2_Z7N: FZ7N.2, OCZ7N.6 (MT2)
FMT2_Z7P: FZ7P.2, OCZ7P.6 (MT2)
FMT2_Z8N: FZ8N.2, OCZ8N.6 (MT2)
FMT2_Z8P: FZ8P.2, OCZ8P.6 (MT2)
FP1: DZ1N.1, DZ1P.2, J2.1; also elsewhere on the board
FP2: DZ2N.1, DZ2P.2, J2.2; also elsewhere on the board
FP3: DZ3N.1, DZ3P.2, J3.1; also elsewhere on the board
FP4: DZ4N.1, DZ4P.2, J3.2; also elsewhere on the board
FP5: DZ5N.1, DZ5P.2, J4.1
FP6: DZ6N.1, DZ6P.2, J4.2
FP7: DZ7N.1, DZ7P.2, J5.1
FP8: DZ8N.1, DZ8P.2, J5.2
GND: C1.2, C2.2, JWS.3 (L3), PS1.4 (DC-), QZ1N.3 (E), QZ1P.3 (E), QZ2N.3 (E), QZ2P.3 (E), QZ3N.3 (E), QZ3P.3 (E), QZ4N.3 (E), QZ4P.3 (E), QZ5N.3 (E), QZ5P.3 (E), QZ6N.3 (E), QZ6P.3 (E), QZ7N.3 (E), QZ7P.3 (E), QZ8N.3 (E), QZ8P.3 (E), U1.2 (GND)
GPIO1: JWS.16 (L16), RBZ1P.1
GPIO2: JWS.15 (L15), RBZ1N.1
GPIO3: JWS.14 (L14), RBZ5P.1
GPIO15: JWS.12 (L12), RBZ2P.1
GPIO16: JWS.9 (L9), RBZ2N.1
GPIO17: JWS.7 (L7), RBZ3P.1
GPIO18: JWS.10 (L10), RBZ3N.1
GPIO21: JWS.6 (L6), RBZ4P.1
GPIO38: JWS.34 (R34), RBZ5N.1
GPIO39: JWS.32 (R32), RBZ6P.1
GPIO40: JWS.31 (R31), RBZ6N.1; also elsewhere on the board
GPIO41: JWS.30 (R30), RBZ7P.1
GPIO42: JWS.29 (R29), RBZ7N.1
GPIO45: JWS.27 (R27), RBZ4N.1
GPIO47: JWS.25 (R25), RBZ8P.1
GPIO48: JWS.24 (R24), RBZ8N.1
LEDA_Z1N: OCZ1N.1 (LED_A), RLZ1N.2
LEDA_Z1P: OCZ1P.1 (LED_A), RLZ1P.2
LEDA_Z2N: OCZ2N.1 (LED_A), RLZ2N.2
LEDA_Z2P: OCZ2P.1 (LED_A), RLZ2P.2
LEDA_Z3N: OCZ3N.1 (LED_A), RLZ3N.2
LEDA_Z3P: OCZ3P.1 (LED_A), RLZ3P.2
LEDA_Z4N: OCZ4N.1 (LED_A), RLZ4N.2
LEDA_Z4P: OCZ4P.1 (LED_A), RLZ4P.2
LEDA_Z5N: OCZ5N.1 (LED_A), RLZ5N.2
LEDA_Z5P: OCZ5P.1 (LED_A), RLZ5P.2
LEDA_Z6N: OCZ6N.1 (LED_A), RLZ6N.2
LEDA_Z6P: OCZ6P.1 (LED_A), RLZ6P.2
LEDA_Z7N: OCZ7N.1 (LED_A), RLZ7N.2
LEDA_Z7P: OCZ7P.1 (LED_A), RLZ7P.2
LEDA_Z8N: OCZ8N.1 (LED_A), RLZ8N.2
LEDA_Z8P: OCZ8P.1 (LED_A), RLZ8P.2
LEDK_Z1N: OCZ1N.2 (LED_K), QZ1N.2 (C)
LEDK_Z1P: OCZ1P.2 (LED_K), QZ1P.2 (C)
LEDK_Z2N: OCZ2N.2 (LED_K), QZ2N.2 (C)
LEDK_Z2P: OCZ2P.2 (LED_K), QZ2P.2 (C)
LEDK_Z3N: OCZ3N.2 (LED_K), QZ3N.2 (C)
LEDK_Z3P: OCZ3P.2 (LED_K), QZ3P.2 (C)
LEDK_Z4N: OCZ4N.2 (LED_K), QZ4N.2 (C)
LEDK_Z4P: OCZ4P.2 (LED_K), QZ4P.2 (C)
LEDK_Z5N: OCZ5N.2 (LED_K), QZ5N.2 (C)
LEDK_Z5P: OCZ5P.2 (LED_K), QZ5P.2 (C)
LEDK_Z6N: OCZ6N.2 (LED_K), QZ6N.2 (C)
LEDK_Z6P: OCZ6P.2 (LED_K), QZ6P.2 (C)
LEDK_Z7N: OCZ7N.2 (LED_K), QZ7N.2 (C)
LEDK_Z7P: OCZ7P.2 (LED_K), QZ7P.2 (C)
LEDK_Z8N: OCZ8N.2 (LED_K), QZ8N.2 (C)
LEDK_Z8P: OCZ8P.2 (LED_K), QZ8P.2 (C)
LOCAL_5V: DPWR.1, PS1.3 (DC+); also elsewhere on the board
MAINS_L: F0.1, J1.1
MAINS_N: J1.2, PS1.2 (AC_N)
MT1D_Z1N: DZ1N.2, OCZ1N.4 (MT1)
MT1D_Z1P: DZ1P.1, OCZ1P.4 (MT1)
MT1D_Z2N: DZ2N.2, OCZ2N.4 (MT1)
MT1D_Z2P: DZ2P.1, OCZ2P.4 (MT1); also elsewhere on the board
MT1D_Z3N: DZ3N.2, OCZ3N.4 (MT1)
MT1D_Z3P: DZ3P.1, OCZ3P.4 (MT1); also elsewhere on the board
MT1D_Z4N: DZ4N.2, OCZ4N.4 (MT1)
MT1D_Z4P: DZ4P.1, OCZ4P.4 (MT1); also elsewhere on the board
MT1D_Z5N: DZ5N.2, OCZ5N.4 (MT1)
MT1D_Z5P: DZ5P.1, OCZ5P.4 (MT1)
MT1D_Z6N: DZ6N.2, OCZ6N.4 (MT1)
MT1D_Z6P: DZ6P.1, OCZ6P.4 (MT1)
MT1D_Z7N: DZ7N.2, OCZ7N.4 (MT1); also elsewhere on the board
MT1D_Z7P: DZ7P.1, OCZ7P.4 (MT1)
MT1D_Z8N: DZ8N.2, OCZ8N.4 (MT1); also elsewhere on the board
MT1D_Z8P: DZ8P.1, OCZ8P.4 (MT1); also elsewhere on the board
PHASE_PROT: F0.2, PS1.1 (AC_L), RSZ1N.1, RSZ1P.1, RSZ2N.1, RSZ2P.1, RSZ3N.1, RSZ3P.1, RSZ4N.1, RSZ4P.1, RSZ5N.1, RSZ5P.1, RSZ6N.1, RSZ6P.1, RSZ7N.1, RSZ7P.1, RSZ8N.1, RSZ8P.1
QB_Z1N: QZ1N.1 (B), RBZ1N.2
QB_Z1P: QZ1P.1 (B), RBZ1P.2
QB_Z2N: QZ2N.1 (B), RBZ2N.2
QB_Z2P: QZ2P.1 (B), RBZ2P.2
QB_Z3N: QZ3N.1 (B), RBZ3N.2
QB_Z3P: QZ3P.1 (B), RBZ3P.2
QB_Z4N: QZ4N.1 (B), RBZ4N.2
QB_Z4P: QZ4P.1 (B), RBZ4P.2
QB_Z5N: QZ5N.1 (B), RBZ5N.2
QB_Z5P: QZ5P.1 (B), RBZ5P.2
QB_Z6N: QZ6N.1 (B), RBZ6N.2
QB_Z6P: QZ6P.1 (B), RBZ6P.2
QB_Z7N: QZ7N.1 (B), RBZ7N.2
QB_Z7P: QZ7P.1 (B), RBZ7P.2
QB_Z8N: QZ8N.1 (B), RBZ8N.2
QB_Z8P: QZ8P.1 (B), RBZ8P.2
RSF_Z1N: FZ1N.1, RSZ1N.2
RSF_Z1P: FZ1P.1, RSZ1P.2
RSF_Z2N: FZ2N.1, RSZ2N.2
RSF_Z2P: FZ2P.1, RSZ2P.2
RSF_Z3N: FZ3N.1, RSZ3N.2
RSF_Z3P: FZ3P.1, RSZ3P.2
RSF_Z4N: FZ4N.1, RSZ4N.2
RSF_Z4P: FZ4P.1, RSZ4P.2
RSF_Z5N: FZ5N.1, RSZ5N.2
RSF_Z5P: FZ5P.1, RSZ5P.2
RSF_Z6N: FZ6N.1, RSZ6N.2
RSF_Z6P: FZ6P.1, RSZ6P.2
RSF_Z7N: FZ7N.1, RSZ7N.2
RSF_Z7P: FZ7P.1, RSZ7P.2
RSF_Z8N: FZ8N.1, RSZ8N.2
RSF_Z8P: FZ8P.1, RSZ8P.2
VSYS: C1.1, DPWR.2, JWS.2 (L2), U1.1 (IN)

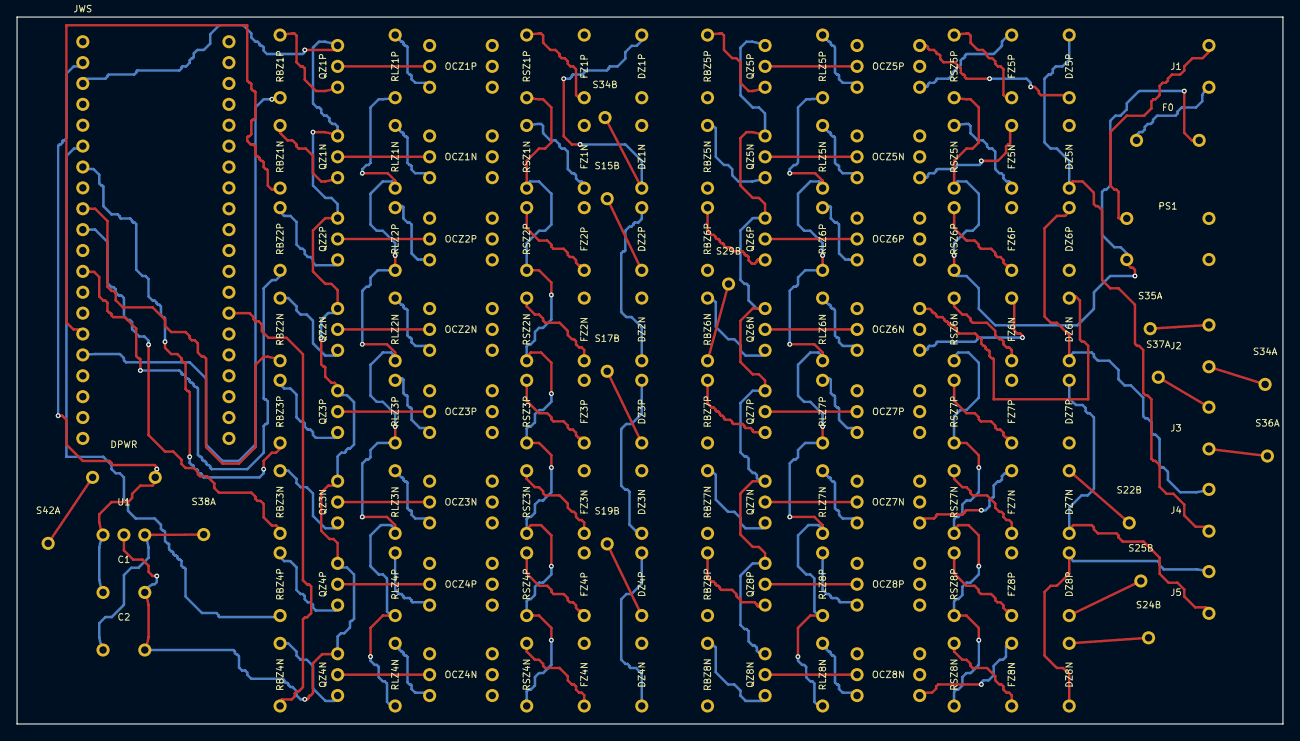
[picture p4: board FilPilote_8Zones.kicad_pcb from above]

Board: 2 copper layers, 154.0 x 86.0 mm, 138 parts (0 on the bottom side), 127 nets.

Other parts of the board:
S15B, S17B, S19B, S22B, S24B, S25B, S29B, S34A, S34B, S35A, S36A, S37A, S38A, S42A: strap; ANCHOR1

Their connections:
3V3_OPTO: S38A.1; also elsewhere on the board
FP1: S34A.1, S34B.1; also elsewhere on the board
FP2: S35A.1; also elsewhere on the board
FP3: S36A.1; also elsewhere on the board
FP4: S37A.1; also elsewhere on the board
GPIO40: S29B.1; also elsewhere on the board
LOCAL_5V: S42A.1; also elsewhere on the board
MT1D_Z2P: S15B.1; also elsewhere on the board
MT1D_Z3P: S17B.1; also elsewhere on the board
MT1D_Z4P: S19B.1; also elsewhere on the board
MT1D_Z7N: S22B.1; also elsewhere on the board
MT1D_Z8N: S24B.1; also elsewhere on the board
MT1D_Z8P: S25B.1; also elsewhere on the board
