EtienneESP32/fil-pilote-8-zones-eedomus/(commit log)

2026-11-06 Dossier initial : cahier des charges, architecture, nomenclature et revue fil pilote 8 zones
    Documentation de travail pour une carte contrôleur fil pilote 8 zones (ESP32-S3-POE-ETH,
    eedomus/HTTP), reprise du cahier des charges source et clôture de plusieurs points de
    conception (codage des 6 ordres GIFAM, pinout Waveshare, résistances/fusibles côté secteur).
    Projet encore en étude : ne pas fabriquer ni raccorder au secteur sans revue compétente.
    [SCH_FilPilote_8Zones_DIN_2_2026-11-06.json]
2026-11-06 Projet KiCad natif : schema ERC-clean et PCB place/DRC-clean pour les 8 zones
    Reprend la conception a partir des decisions fermees (GPIO corriges, etage
    tampon transistor, 4,7 kOhm + fusibles secteur, HLK-5M05, MOC3063M) et les
    traduit en schema electrique complet (0 erreur ERC) puis en implantation PCB
    respectant la separation secteur/logique (0 erreur DRC reelle, routage non
    fait). Met a jour les docs en consequence (gabarit de carte 105x180mm au lieu
    de 105x85mm, etat du projet KiCad).
    [FilPilote_8Zones.kicad_pcb, FilPilote_8Zones.kicad_sch]
2026-11-06 Corrige l'empreinte du connecteur Waveshare (etait 1 rangee/19 broches, faux)
    L'implantation precedente modelisait le connecteur de la carte Waveshare
    ESP32-S3-ETH par un en-tete generique 1 rangee de 19 broches sans rapport
    avec le vrai composant (signale par l'utilisateur). Verification faite
    contre le pinout physique reel : en-tete 40 broches compatible Raspberry
    Pi Pico, 2 rangees de 20, pas 2,54mm, rangees espacees de 17,78mm (carte
    72,8x21mm). Refait a l'identique et verifie par inspection directe des
    coordonnees de pastilles generees.
    Le pinout physique reel a revele deux erreurs GPIO supplementaires :
    GPIO4/GPIO5 (zones 4/5) ne sortent en realite que sur le connecteur carte
    TF, pas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
    [FilPilote_8Zones.kicad_pcb, FilPilote_8Zones.kicad_sch]
2026-11-06 Recompacte le PCB a 192x86mm pour tenir dans un boitier DIN standard
    Etude du boitier CamdenBoss CNMB (norme DIN 43880, disponible chez RS
    Components) : section fixe 90mm externe / 86,5mm de PCB utilisable,
    independante du nombre de modules (qui ne fixe que la longueur). La
    carte 192x108mm precedente depassait cette section. Recompactee a
    192x86mm (pas des bandes de zones resserre, degagement de bord
    recalcule avec le rayon reel des pastilles) pour tenir en carte unique
    sous le seuil, plutot qu'un empilement de 2 PCB.
    CNMB/12 retenu comme boitier candidat : decoupe RJ45 et guide-fils
    5,08mm disponibles en piece standard dans cette gamme, repondant a
    deux points ouverts du dossier (acces RJ4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
    [FilPilote_8Zones.kicad_pcb]
2026-11-06 Corrige l'orientation des borniers de cablage externe (J1, J2-J5)
    Les borniers recevant du cablage externe (entree secteur, sorties fil
    pilote) etaient poses a plat, axe des 2 broches parallele au bord de
    carte - sans rapport avec le sens de sortie reel d'un cable, signale
    par l'utilisateur. Tournes a 90 degres pour que l'axe des broches soit
    perpendiculaire au bord droit (sortie fil vers l'exterieur). Verifie
    par inspection directe des coordonnees de pastilles generees (export
    SVG), pas seulement par le rendu visuel.
    F0 et PS1 (fusible, module HLK-5M05) n'ont pas de cablage externe
    direct, orientation laissee inchangee.
    DRC revalide a 0 erreur reelle.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
    [FilPilote_8Zones.kicad_pcb]
2026-11-07 Finalise le choix du coffret CNMB/12 : couvercle transparent, accessoires
    Couvercle transparent choisi par l'utilisateur (CNMB/12/PC). Decisions
    prises pour le reste des accessoires :
    - Base CNMB/12/2 (acces bornier aux deux extremites)
    - CNMB/3/TGRJ45 cote Waveshare (decoupe RJ45)
    - CNMB/3/TG508 cote sorties FP (guide-fils 9 poles, 5,08mm, couvre
    les 8 poles de J2-J5)
    - Entree secteur J1 cablee en fixe par presse-etoupe plutot qu'en
    bornier debrochable (evite un debranchement accidentel d'un
    conducteur 230V)
    Point ouvert Q7 (coffret) ferme.
2026-11-07 Simplifie l'alimentation PoE/local : retire le selecteur, schema reel verifie
    Recupere et lu le schema electrique officiel Waveshare ESP32-S3-ETH
    (files.waveshare.com/wiki/ESP32-S3-ETH/ESP32-S3-ETH-Schematic.pdf) pour
    resoudre le point ouvert sur la broche "sortie PoE".
    Constat : POE_5V (sortie du module PoE) est le meme net que VBUS (USB-C)
    cote Waveshare ; le module PoE s'enfiche sur un connecteur interne dedie,
    invisible depuis l'en-tete 40 broches. VSYS (broche 2) est la seule
    entree d'alimentation externe accessible, deja commutee en interne entre
    VBUS/PoE par un MOSFET (Q3, APM2307).
    Consequence : il n'y a rien a selectionner entre deux broches externes.
    Le selecteur manuel SW1 prevu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
    [FilPilote_8Zones.kicad_pcb, FilPilote_8Zones.kicad_sch]
2026-11-07 Verifie la profondeur du boitier CNMB/12 : marge confortable (~2x)
    Calcul de l'empilement reel depuis le PCB porteur jusqu'au point le
    plus haut : support femelle 2,54mm (8,5mm) + epaisseur PCB Waveshare
    (1,6mm) + prise RJ45 a magnetiques integrees HC-RJ45 (~13,4mm,
    reference vue sur le schema reel) = ~23,5mm.
    Cote boitier : 58mm de profondeur externe moins parois et plots de
    fixation (~5mm) laisse ~49mm de degagement utile.
    Marge ~2x le besoin : la profondeur n'est pas un facteur limitant.
    Dernier point ouvert du dossier materiel (hors routage et firmware)
    ferme.
2026-11-07 Ajoute le guide de routage PCB (docs/12)
    Procedure a suivre dans l'editeur graphique KiCad pour router la carte :
    classes de net (logique vs secteur, largeurs, clearance 6mm), ordre de
    routage recommande, regles a observer pendant le routage, checklist de
    finition avant export des fichiers de fabrication.
2026-11-07 Routage automatise partiel (48 pistes) par script + verification DRC
    Tente un "autorouteur maison" pour les 6 connexions internes a chaque
    canal (QB, LEDK, LEDA, RSF, FMT2, MT1D), meme methode que le placement :
    generation en texte + verification DRC systematique.
    Resultat : QB et LEDA (+RSF) routees avec succes (48 segments, 16
    canaux x 3 nets, 0 erreur DRC) car elles relient des composants
    directement voisins. LEDK/FMT2/MT1D abandonnees apres test : elles
    relient des composants separes de 2-3 pas, et la ligne droite directe
    court-circuite le(s) composant(s) intermediaire(s) (confirme par de
    vrais courts-circuits DRC au premier essai). Une piste correcte pour
    ces 3 nets demande un detour q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
    [FilPilote_8Zones.kicad_pcb]
2026-11-07 fix(pcb): obstacles de pathfinding par broche au lieu du composant entier
    Le modele d'obstacle precedent excluait tout le rectangle de courtyard
    d'un composant des qu'une piste visait une de ses broches, laissant le
    chemin libre de traverser les AUTRES broches de ce meme composant.
    Confirme par de vrais courts-circuits DRC sur des boitiers a broches
    rapprochees (DIP6, TO92, pas 1,27-2,54mm) : LEDA_Z7N/OCZ7N, QB_Z5N/QZ5N.
    Chaque broche (connectee ou non) devient son propre obstacle ; seules
    les deux broches exactement visees par la piste en cours sont exclues
    (par coordonnee), le reste du composant reste bloquant. Resultat :
    90/188 connexions auto-routees (vs 86 precedemment), 0 erreur DRC
    r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
    [FilPilote_8Zones.kicad_pcb]
2026-11-07 feat(pcb): autorouteur A* bicouche (F.Cu/B.Cu + vias)
    Le routeur a pin, une seule couche (B.Cu), saturait vite : les familles
    LEDK_*/FMT2_*/MT1D_* echouaient en bloc (16/16 canaux) alors que des
    nets routes juste avant (LEDA_*/QB_*/RSF_*) empruntaient des trajets
    tout aussi longs avec succes - signe que la cause etait la saturation
    de l'unique couche disponible, pas la geometrie.
    Recherche A* etendue a un etat (x,y,couche) : F.Cu et B.Cu recherches
    simultanement, changement de couche (via) autorise a cout de detour
    (equivalent 5mm) partout ou l'autre couche est libre au meme point.
    Bug PowerShell trouve au passage : Split-PathByLayer renvoyait sa liste
    de troncons via `return $runs` - Powe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
    [FilPilote_8Zones.kicad_pcb]
2026-11-07 feat(pcb): 2e passe de routage (fenetre large + grille fine) sur les echecs
    Ajoute une 2e passe ciblee uniquement sur les connexions qui ont echoue
    a la 1ere : fenetre de recherche 60mm (vs 20mm) et grille 0,5mm (vs
    1mm), pour trouver les interstices sub-millimetriques entre obstacles
    qu'une grille grossiere arrondit a "bloque". Contrairement a un
    elargissement en 1ere passe (deja teste et rejete : ca degradait les
    nets encore en file en leur laissant consommer plus de place), cette
    2e passe ne joue plus contre personne puisque tout le reste est deja
    fixe au moment ou elle s'execute.
    Resultat : 157 -> 172 connexions routees sur 188 (0 erreur DRC reelle,
    inchangee). Teste et documente aussi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
    [FilPilote_8Zones.kicad_pcb]
2026-11-07 fix(pcb): isolement secteur/logique reellement verifie par le DRC (securite)
    La separation de 6mm secteur/logique documentee depuis le 2026-11-06
    n'etait verifiee nulle part : aucune classe de net "Secteur"/"Logique"
    n'existait dans le projet KiCad, le DRC appliquait seulement la
    clearance generique (0,2mm) partout, y compris entre PHASE_PROT (230V)
    et GPIO (logique).
    Ajoute 2 vraies classes de net (FilPilote_8Zones.kicad_pro) et une
    regle DRC personnalisee conditionnelle (FilPilote_8Zones.kicad_dru,
    6mm uniquement a la frontiere Secteur<->Logique, pas a l'interieur
    d'une classe). L'activer a immediatement revele 234 violations reelles
    sur le board precedent (172 connexions routees), dont 5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
    [FilPilote_8Zones.kicad_pcb]
2026-11-07 feat(pcb): generer les straps directement dans le PCB, pas seulement dans la doc
    Les 35 connexions que l'autorouteur ne peut pas fermer en cuivre (2
    couches saturees localement) etaient seulement decrites en markdown -
    le fichier .kicad_pcb lui-meme ne montrait rien de concret a faire.
    Ajoute Add-Strap : pour chaque echec final, dessine automatiquement le
    trajet exact (ligne pointillee pastille-a-pastille) et une etiquette
    texte sur la couche Dwgs.User (repere de montage, non fabrique - jamais
    une fausse piste cuivre qui risquerait d'etre gravee par erreur comme
    un raccourci entre 2 zones qui ne doivent pas se toucher). Le ratsnest
    reste "non connecte" pour ces nets jusqu'au soudage reel du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
    [FilPilote_8Zones.kicad_pcb]
2026-11-07 docs(pcb): verif complete + piege kicad-cli qui corrompt le .kicad_pro
    Verification de bout en bout demandee : schema+ERC et PCB+DRC
    regeneres et confirmes identiques a l'etat commite (0 erreur reelle
    des deux cotes).
    Trouve au passage un vrai piege kicad-cli, documente dans
    11_Etat-KiCad.md : "kicad-cli pcb drc" ET "kicad-cli pcb export svg"
    utilisent correctement les classes de net Logique/Secteur pour le
    calcul demande, MAIS reecrivent ensuite FilPilote_8Zones.kicad_pro sur
    disque en les supprimant (seule la classe Default survit). Le resultat
    du DRC au moment ou il tourne reste correct, mais le fichier projet se
    retrouve corrompu juste apres - confirme que ca n'a jamais atteint un
    commi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
    [FilPilote_8Zones.kicad_pcb]
2026-11-07 feat(pcb): lissage des pistes (string pulling) - fini les escaliers inutiles
    Le pathfinder en grille ne se deplace qu'horizontalement/verticalement,
    ce qui produit des escaliers meme quand un trajet direct ou diagonal
    serait tout aussi sur electriquement - signale par l'utilisateur en
    regardant le board.
    Ajoute un lissage par "string pulling" : apres simplification, chaque
    troncon tente de sauter directement au point le plus loin possible
    dans sa suite, tant que la ligne directe (diagonale y compris) reste
    verifiee sure contre les obstacles reels (Test-LineSafe, echantillonnage
    fin, meme regle de marge que le pathfinder lui-meme selon les classes
    Secteur/Logique - jamais une diagonale suppo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
    [FilPilote_8Zones.kicad_pcb]
2026-11-08 fix(pcb): chanfreins de coin propres (pas de diagonales longues) + abandon des ancrages de strap
    Retour utilisateur sur le lissage de trajet precedent (string pulling,
    sautant au point le plus loin possible) : visuellement "sale", trop de
    pistes en biais a angle arbitraire. Remplace par un chanfreinage de
    coin classique (convention PCB standard) : chaque coin a 90 du chemin
    simplifie est coupe sur une petite longueur egale (<=2mm) de ses 2
    segments, relies par un segment a exactement 45. Chaque chanfrein
    reste verifie (Test-LineSafe) avant d'etre retenu.
    Bug trouve et corrige au passage : le calcul du chanfrein referencait
    le point D'ORIGINE du chemin au lieu du dernier point REELLEMENT emi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
    [FilPilote_8Zones.kicad_pcb]
2026-11-08 feat(pcb): carte resserree 192->176mm + reperes silkscreen corriges a la racine
    Demande explicite de l'utilisateur : resserrer les composants discrets
    et reduire la taille de la carte.
    Pas de canal variable remplacant le pas uniforme de 9mm : un composant
    2 broches tourne a 90 n'a quasiment aucun encombrement horizontal
    au-dela du rayon de sa pastille (ses 2 broches s'empilent en Y, pas
    cote a cote en X) - seul l'optotriac (DIP6, non tourne, 9,62mm de large
    reel) a vraiment besoin de marge. gapThin=7mm (entre composants fins),
    gapOC=8mm (de part et d'autre de l'opto). Colonne connectique secteur/
    FP rapprochee de 20mm (vide de ~21mm de cuivre inutilise mesure avant
    ce changement). BOARD_W 1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
    [FilPilote_8Zones.kicad_pcb]
2026-11-08 feat(pcb): valeurs alignees sur les reperes, vide central resserre, ancrages de strap reactives
    3 demandes utilisateur traitees dans ce commit.
    1. Property Value (ex. "1N4007", "10k") alignee sur la logique deja
    appliquee a Reference (voir commit precedent) : meme rotation, meme
    cote, legerement plus loin pour ne pas chevaucher le repere. Pour
    l'optotriac, empilee dans le meme espace vide interne, sous le
    repere de reference.
    2. Vide inutilise de ~21mm repere par l'utilisateur entre la colonne
    gauche de canaux (diodes) et la colonne droite (resistances) :
    zoneRightX0 100->91, colonne secteur/FP recalee d'autant (158/153
    au lieu de 167/162). BOARD_W 176->167mm. Ne touch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
    [FilPilote_8Zones.kicad_pcb]
2026-11-08 fix(pcb): RJ45 aligne sur un bord valide du boitier (pigtail), carte resserree 167->154mm pour CNMB/9
    Correction d'implantation E/S : le module Waveshare (RJ45+USB-C groupes a
    une extremite, confirme par le schema de cotes officiel) sortait vers un
    grand cote FIXE de la carte (sans decoupe CNMB standard), alors que J1-J5
    sortent deja vers une extremite valide. Le tourner coute 72,8mm de largeur -
    incompatible avec la compaction visee. Retenu avec l'utilisateur : le module
    reste monte tel quel, son RJ45 rejoint une prise secondaire au bord oppose
    par un court cordon interne (liaison cable, aucune piste PCB ajoutee).
    Les 3 vides inter-colonnes (JWS/zone gauche, centre, zone droite/secteur)
    so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
    [FilPilote_8Zones.kicad_pcb]
